recrutty/AutotuneGuitar/4_Full_Straight_Back_NA-6c7091648897df9198ad5ace94503ad4.jpg

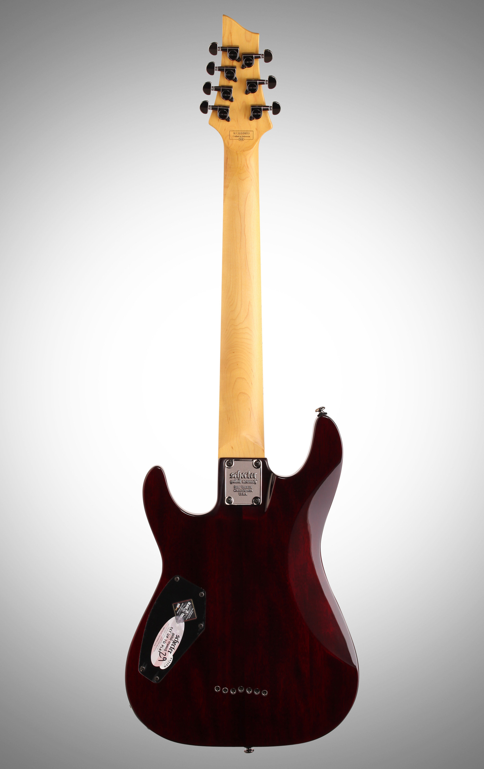
4_Full_Straight_Back_NA-6c7091648897df9198ad5ace94503ad4.jpg
