recrutty/AutotuneGuitar/sepisovani/semestrální projekt/DSC_0964.JPG

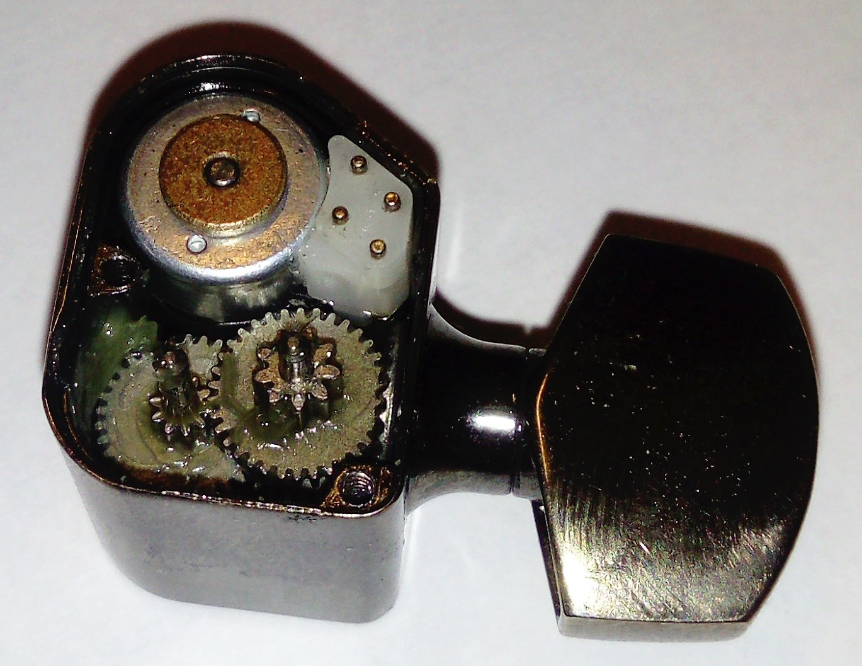
sepisovani/semestrální projekt/DSC_0964.JPG
