recrutty/AutotuneGuitar/sepisovani/Diplomka/prezentace/autotune obhajoba.pdf

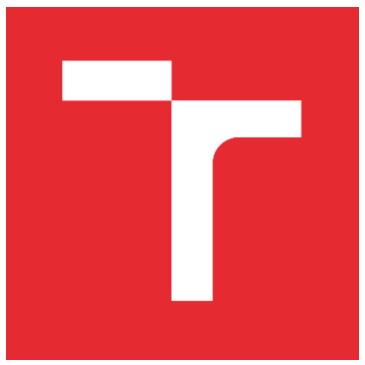
[picture p3: figure]

# SYSTÉM AUTOMATICKÉHO LADĚNÍ PRO SEDMISTRUNNÉ KYTARY

VYPRACOVAL: Bc. VOJTĚCH JEŘÁBEK VEDOUCÍ PRÁCE: Ing. VLADIMÍR LEVEK

# Obsah prezentace

### Systém TronicalTune

### Ladící mechanika RoboHead

### Analýza signálu kytary

### Realizace

### Ukázka funkce

# Systém TronicalTune

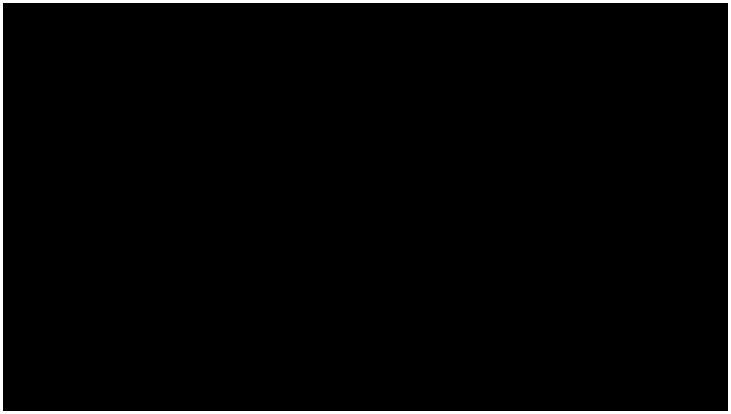
[picture p4: figure]

# Systém TronicalTune

Snímání vibrací
Žádný zásah
do konstrukce kytary

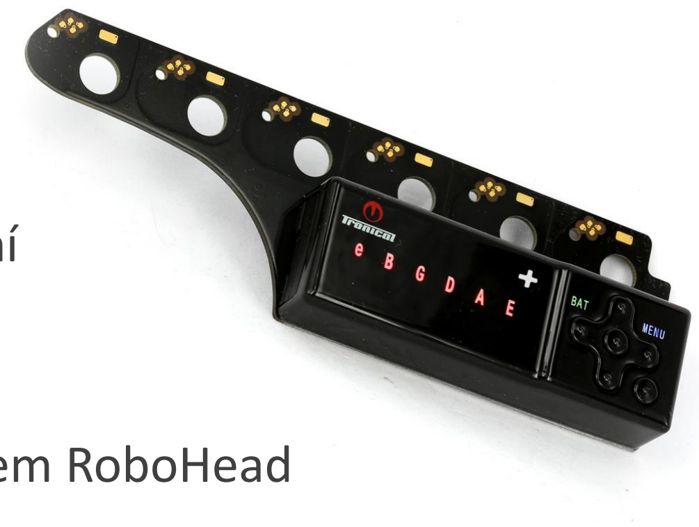
[picture p5: figure]

Možnost ručního ladění
bez použití elektroniky
Ladící mechanika
s integrovaným motorem RoboHead

# Ladící mechanika RoboHead

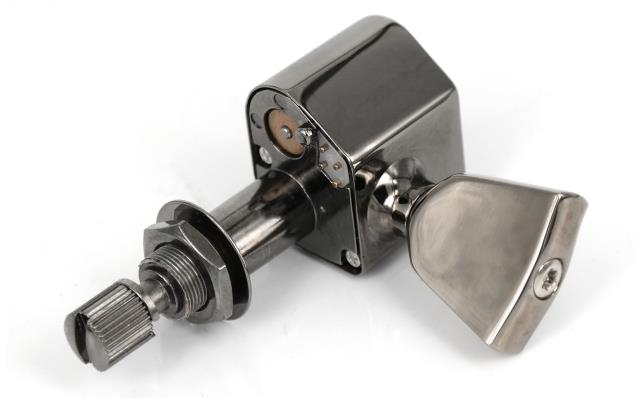
[picture p6: figure]

Dostupné jako náhradní díl pro
systém TronicalTune
Krokový motor
Odpor cívek 16 Ω
3800 kroků na otočení
9 V pro spolehlivé ladění
libovolné struny

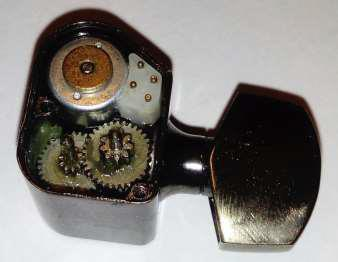
[picture p7: figure]

# Kmitočtová analýza

Struna H1, f = 61,74 Hz
Piezoelektrický senzor
Měření osciloskopem

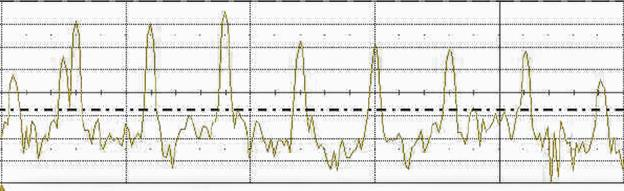
[picture p8: figure]

# Návrh zařízení

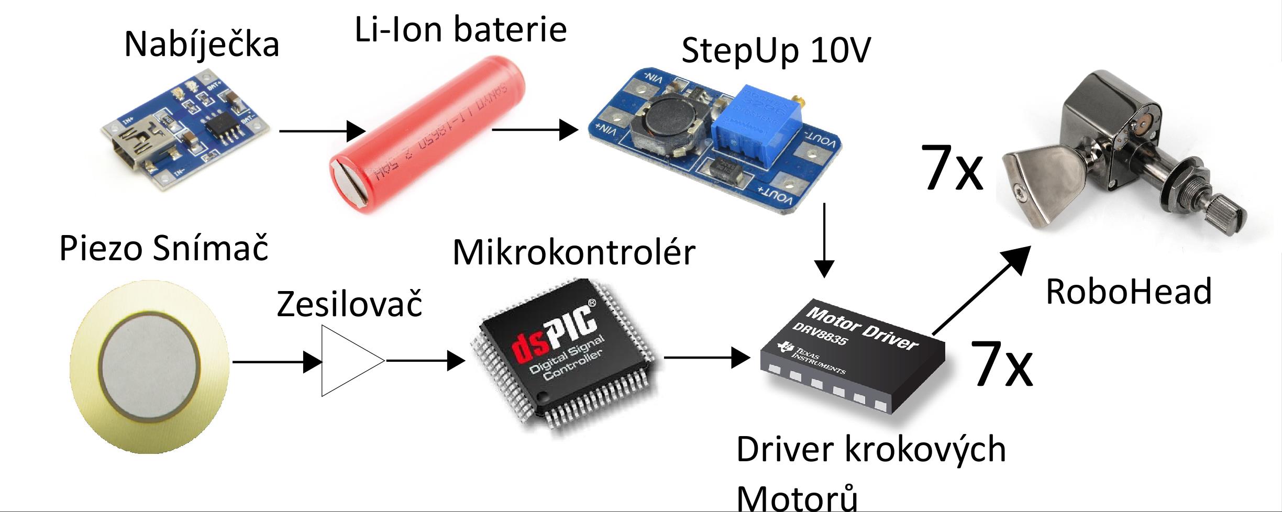
[picture p9: figure]

# Návrh zařízení

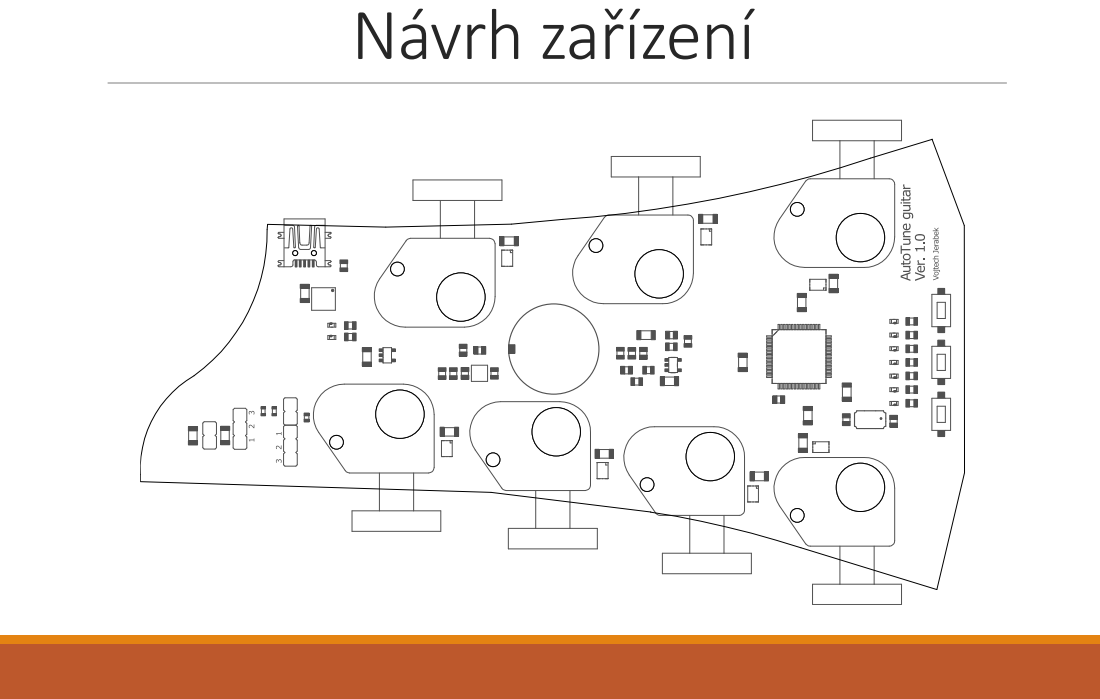
[picture p10: page 8]

# Výsledek

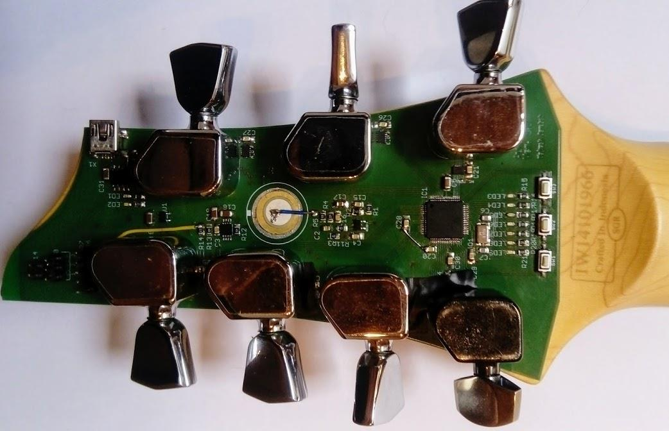
[picture p11: figure]

# Výsledek

### Systém je schopen samostatně pracovat bez dalších komponent

### Výběr a ladění libovolné struny samostatně

### Ochrana před ovlivnění šumem a nesprávným vyhodnocením

# Pokračování

### Integrace všech komponent na DPS

### Doplnění programu o funkci ladění všech strun zároveň, možnosti úpravy ladění

uživatelem a šetření baterie.

### Editace parametrů pomocí USB

# Děkuji za pozornost

PŘEJDEME K PRAKTICKÉ UKÁZCE
