recrutty/AutotuneGuitar/sepisovani/Diplomka/Data/btn.pdf

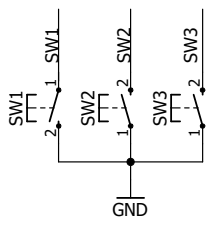
[picture p12: figure]
GND
