recrutty/AutotuneGuitar/sepisovani/Diplomka/Data/nabijecka bokem.pdf

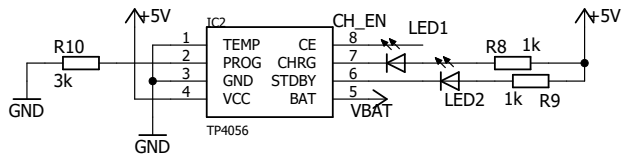
[picture p13: figure]
VBAT; GND; TEMP; PROG; VCC; 4 BAT; STDBY; CHRG; LED1; LED2
