recrutty/AutotuneGuitar/Sem proj obhajoba.pptx

## Systém automatického ladění pro sedmistrunné kytary

VYPRACOVAL: BC. VOJTĚCH JEŘÁBEK
VEDOUCÍ PRÁCE: Ing. Ladislav Macháň

## Obsah prezentace

- Shrnutí zadání a požadavků na práci
- Blokové schéma
- Popis senzorů zvuku a motorů
- Kmitočtová analýza signálu z kytary

## Zadání, požadavky

- Návrh elektrického i mechanického řešení
- Volba metody snímání zvuku
- Použití pro sedmistrunné kytary
- Ladění všech sedmi strun zároveň

## Blokové schéma

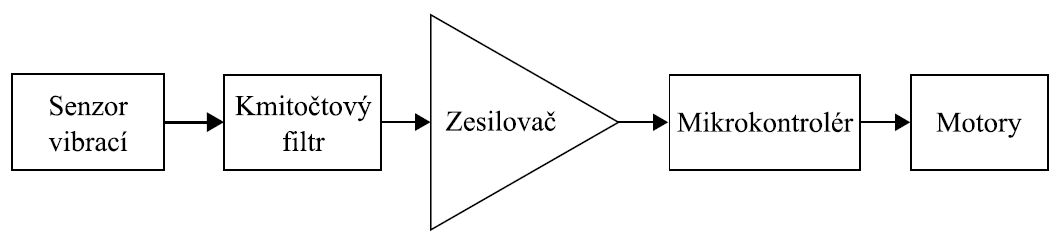
[picture p14: figure]

## Blokové schéma

Senzor vibrací:
- Elektrodynamický
- Piezoelektrický
- MEMS

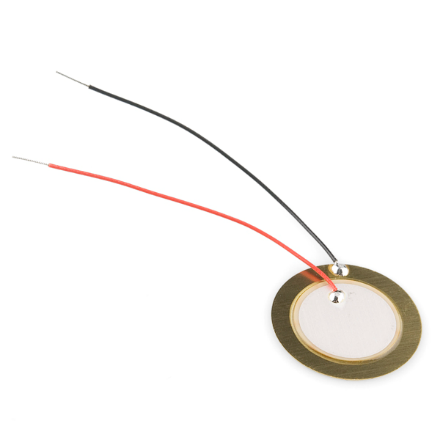
[picture p15: figure]

## Blokové schéma

Ladící mechanika RoboHead
- Krokový motor
- Odpor cívek 16 Ω
- 3800 kroků na otočení

## Kmitočtová analýza, FFT

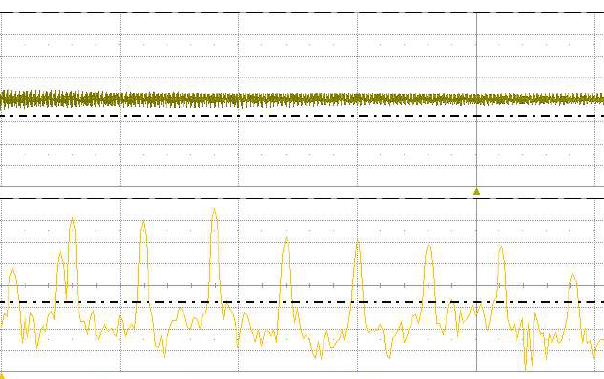
[picture p16: figure]
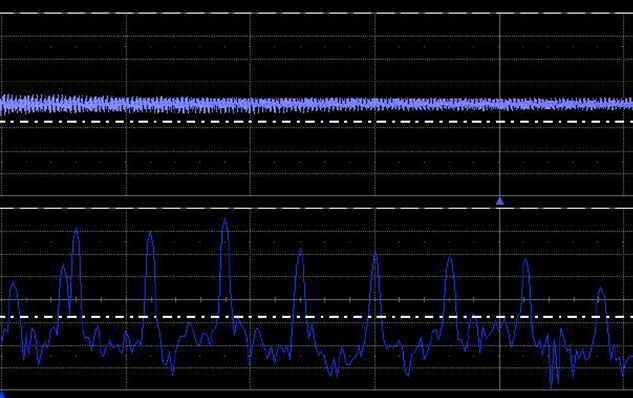
[picture p17: figure]

Struna H1
f = 61,74 Hz
Piezoelektrický
Senzor
Měření
osciloskopem

## Současný stav

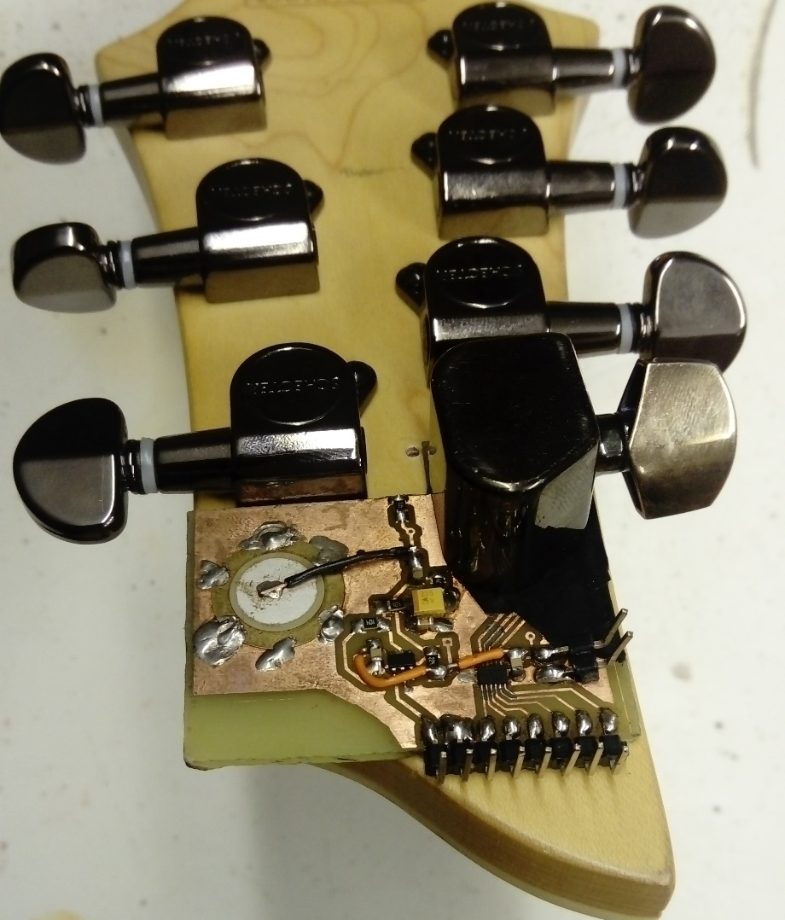
[picture p18: figure]

## Pokračování

- Výběr zbývajících komponent
- Dokončení kompletního schématu
- Konstrukce celého nařízení
- Program pro řízení

## Zdroje

- KUČERA, D. Koncepce tlačítkového piezo-generátoru. Brno: Vysoké učení technické v Brně, Fakulta strojního inženýrství, 2012. 46 s. Vedoucí bakalářské práce Ing. Zdeněk
- TronicalTune revolutionary guitar auto-tuning system unique the world. TronicalTune – selftuning Guitar in seconds! [online]. Hamburg, Germany: Tronical GmbH, 2014 [cit. 2016-11-13]. Dostupné z: http://www.tronical.com/

## Děkuji za pozornost

- Přejdeme k vašim dotazům
