recrutty/AutotuneGuitar/sepisovani/Diplomka/prezentace/EEICT.pdf

oihi

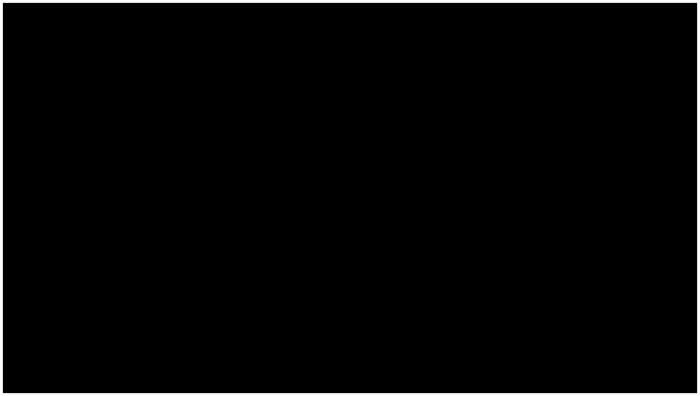
[picture p19: figure]

,jkuhuh
