recrutty/AutotuneGuitar/sepisovani/semestrální projekt/fft oscilo/HDO4024-MS Hardcopy 8.pdf

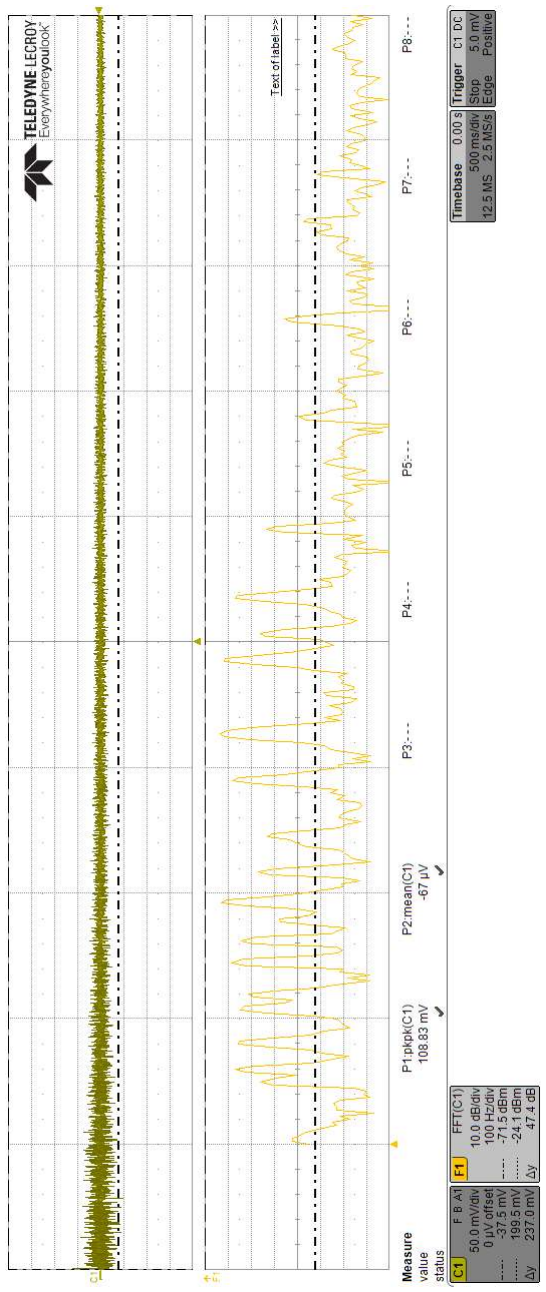
[picture p20: figure]
