recrutty/AutotuneGuitar/sepisovani/semestrální projekt/fft oscilo/HDO4024-MS Hardcopy.pdf

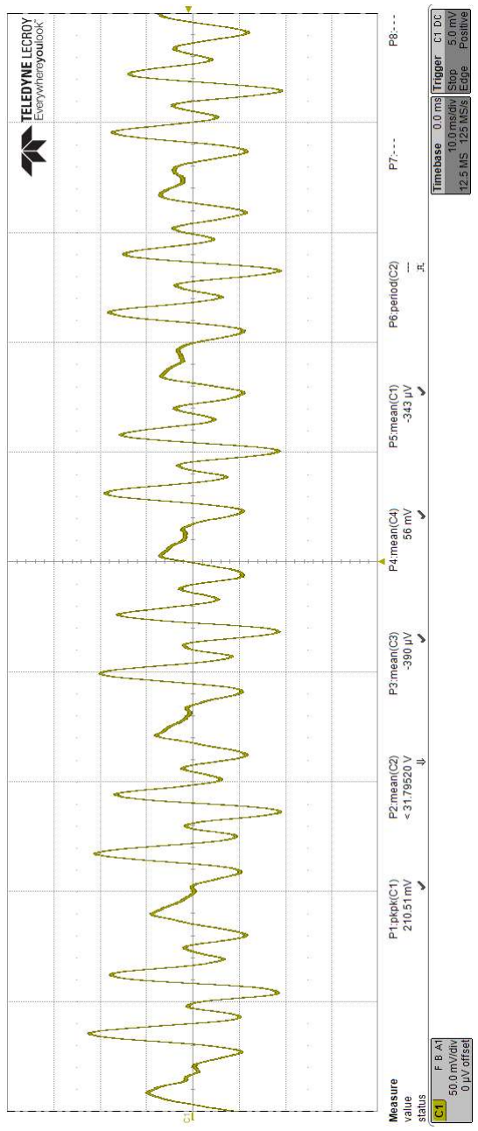
[picture p21: figure]
