recrutty/AutotuneGuitar/sepisovani/semestrální projekt/fft oscilo/HDO4024-MS Hardcopy2.pdf

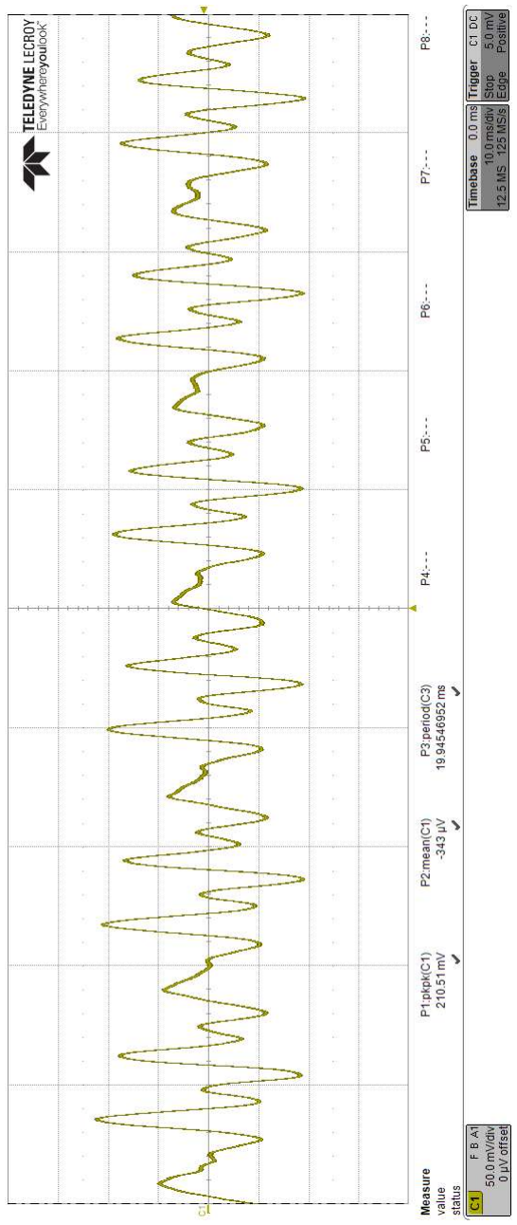
[picture p22: figure]
