recrutty/AutotuneGuitar/sepisovani/semestrální projekt/fft oscilo/HDO4024-MS Hardcopy3.pdf

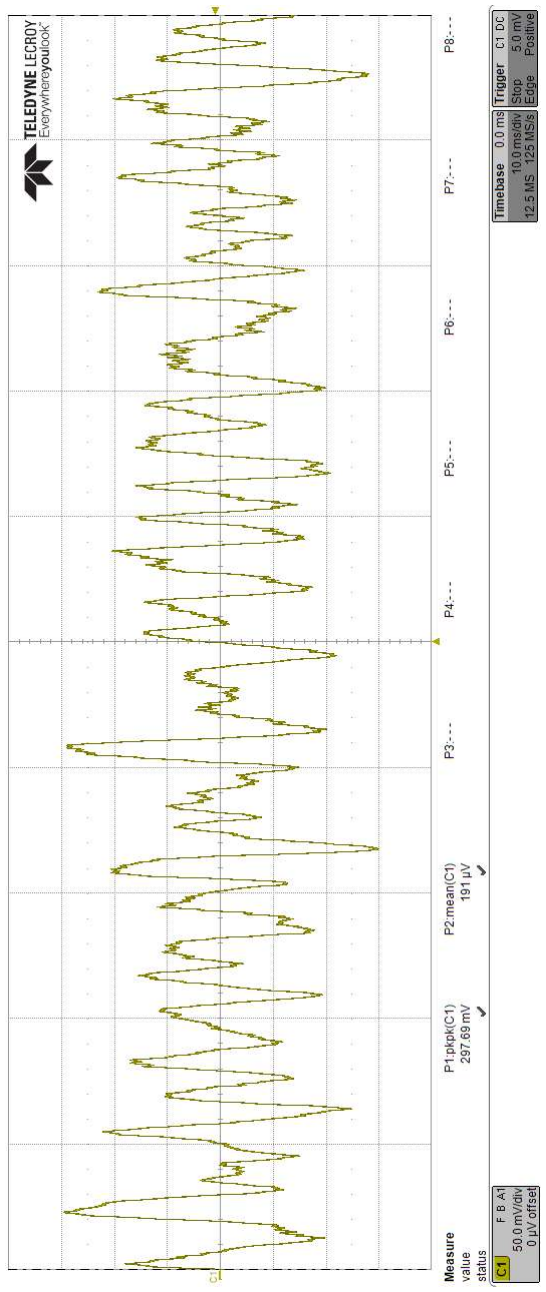
[picture p23: figure]
