recrutty/AutotuneGuitar/sepisovani/semestrální projekt/fft oscilo/HDO4024-MS Hardcopy4.pdf

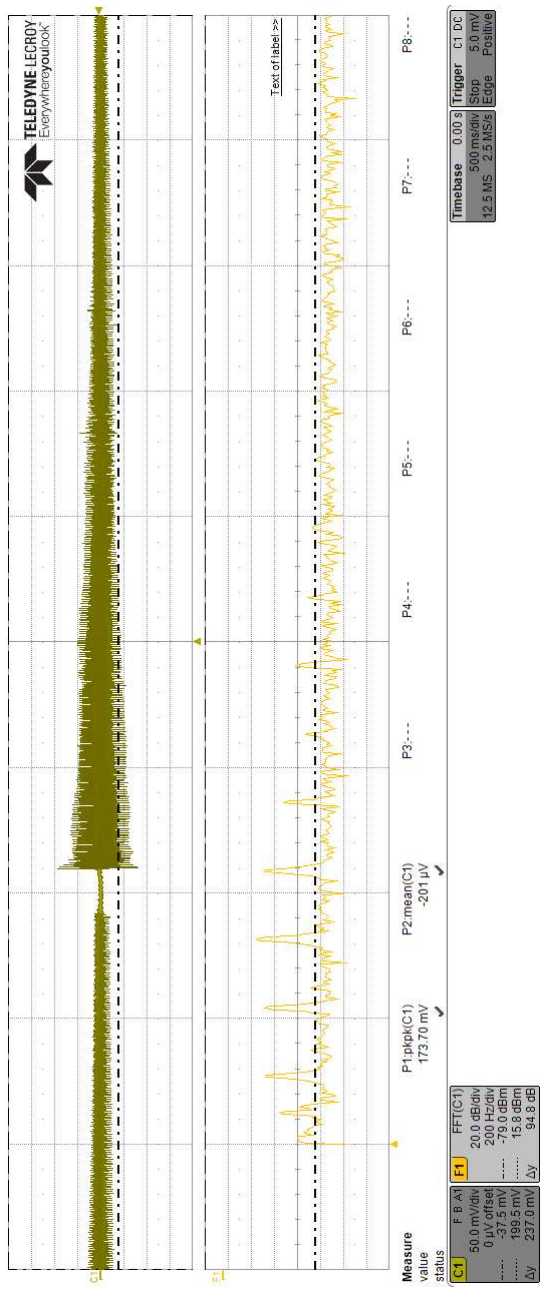
[picture p24: figure]
