recrutty/AutotuneGuitar/Icsp-pinouts.png

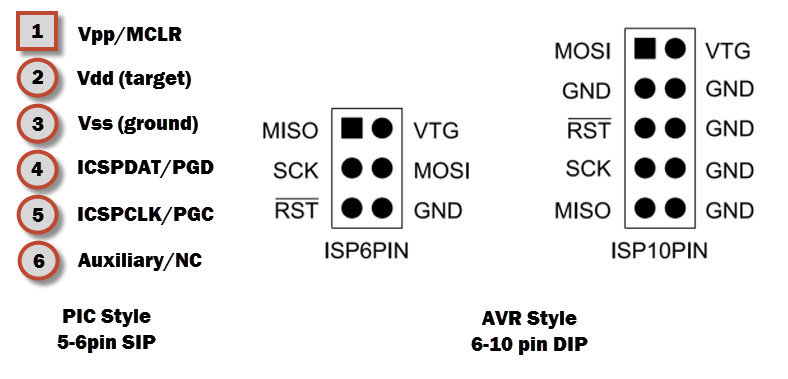
Icsp-pinouts.png
