recrutty/AutotuneGuitar/sepisovani/Diplomka/Data/DSC_0104 (1).JPG

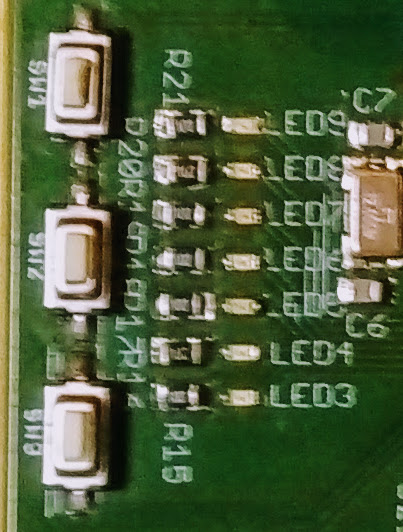
sepisovani/Diplomka/Data/DSC_0104 (1).JPG
