recrutty/AutotuneGuitar/sepisovani/Diplomka/prezentace/FFT.png

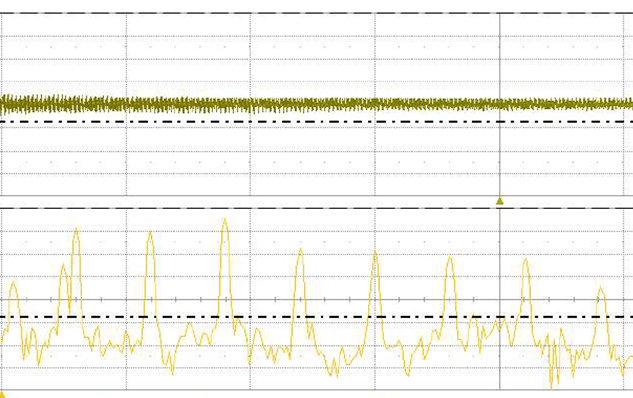
sepisovani/Diplomka/prezentace/FFT.png
