recrutty/AutotuneGuitar/sepisovani/semestrální projekt/DSC_0963.JPG

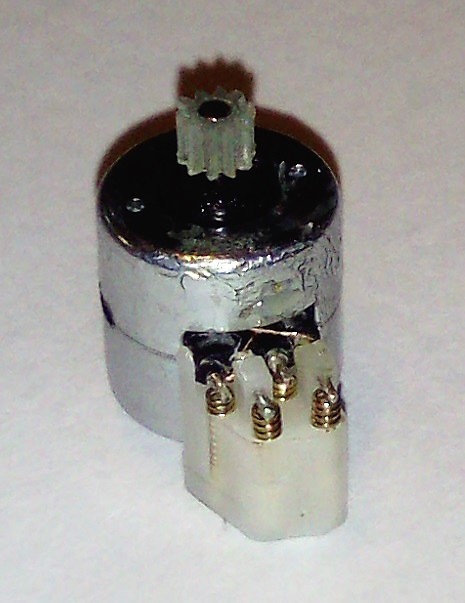
sepisovani/semestrální projekt/DSC_0963.JPG
