recrutty/AutotuneGuitar/sepisovani/semestrální projekt/fft oscilo/all2.png

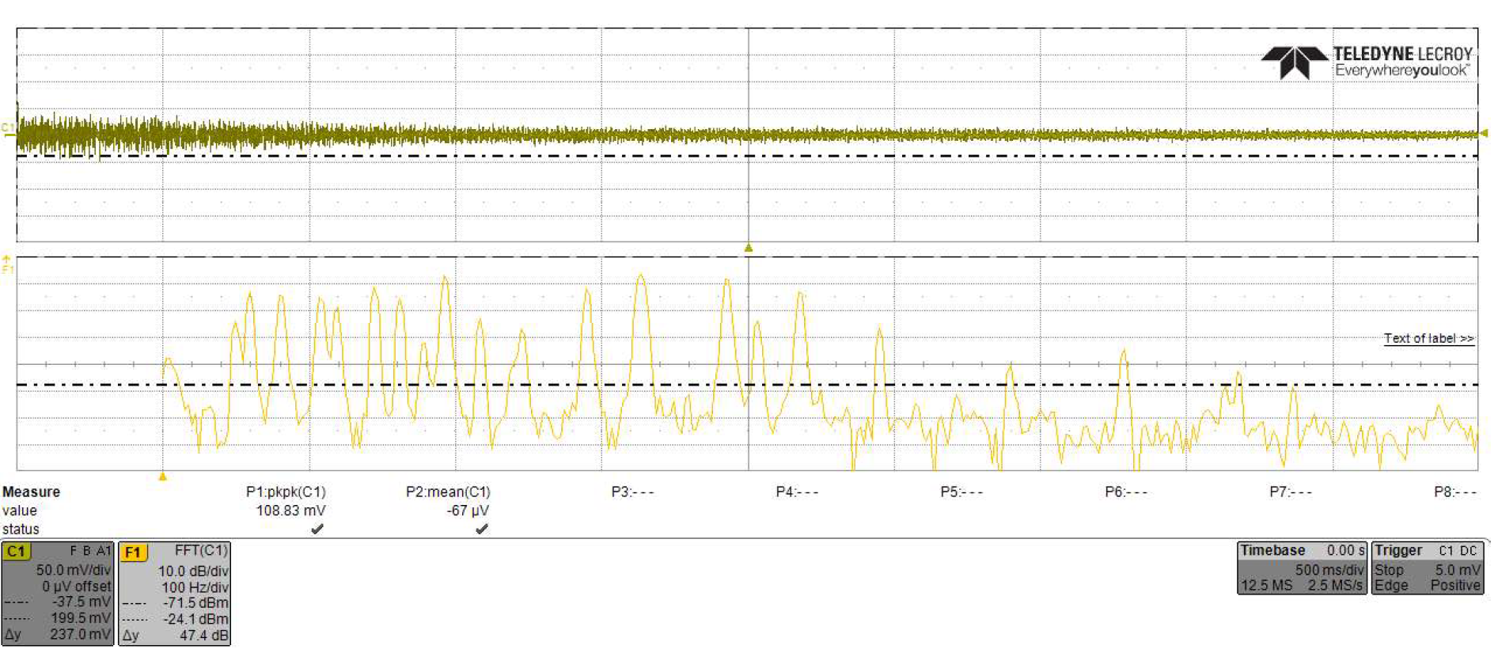
sepisovani/semestrální projekt/fft oscilo/all2.png
