recrutty/AutotuneGuitar/sepisovani/semestrální projekt/fft oscilo/all max.png

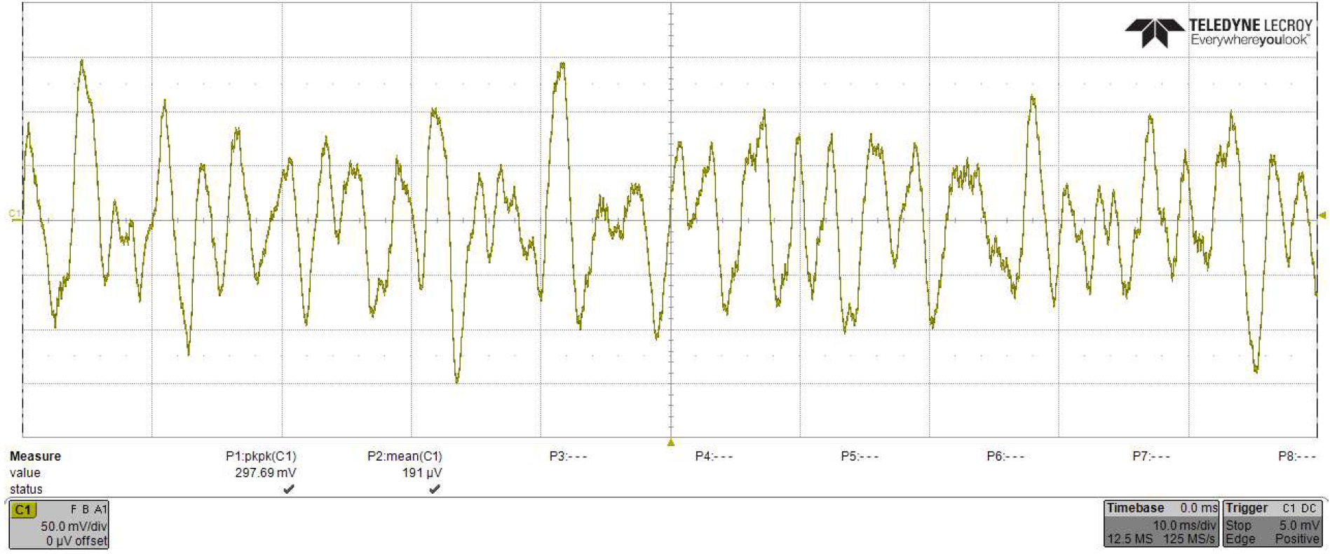
sepisovani/semestrální projekt/fft oscilo/all max.png
