recrutty/AutotuneGuitar/sepisovani/semestrální projekt/fft oscilo/all.png

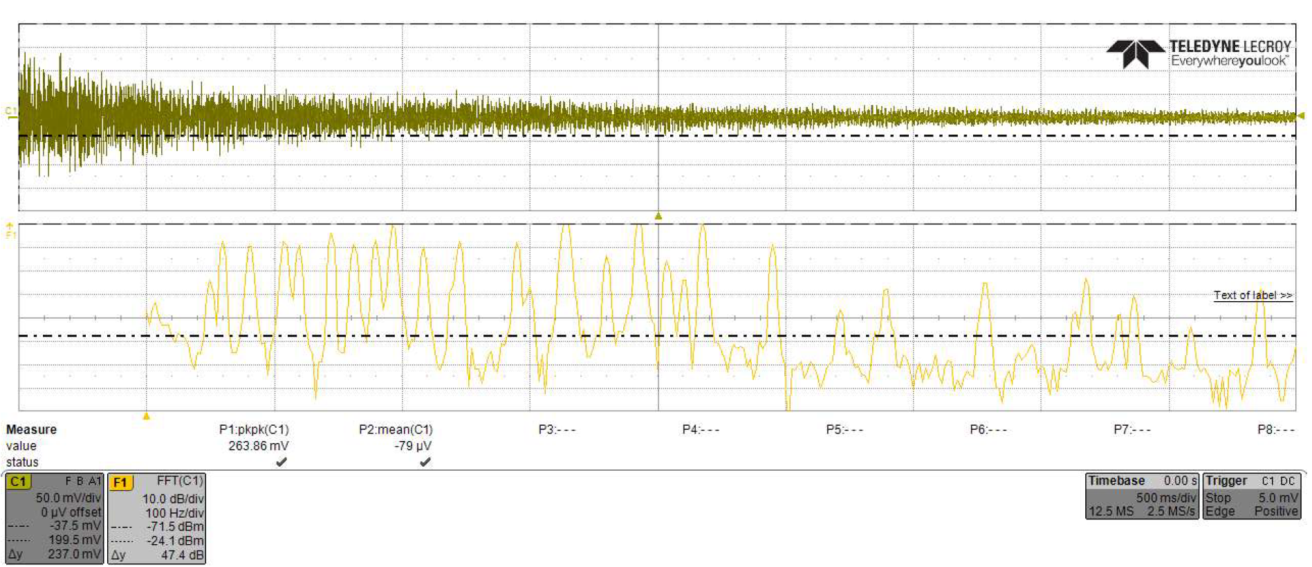
sepisovani/semestrální projekt/fft oscilo/all.png
