recrutty/AutotuneGuitar/sepisovani/semestrální projekt/fft oscilo/h fft.png

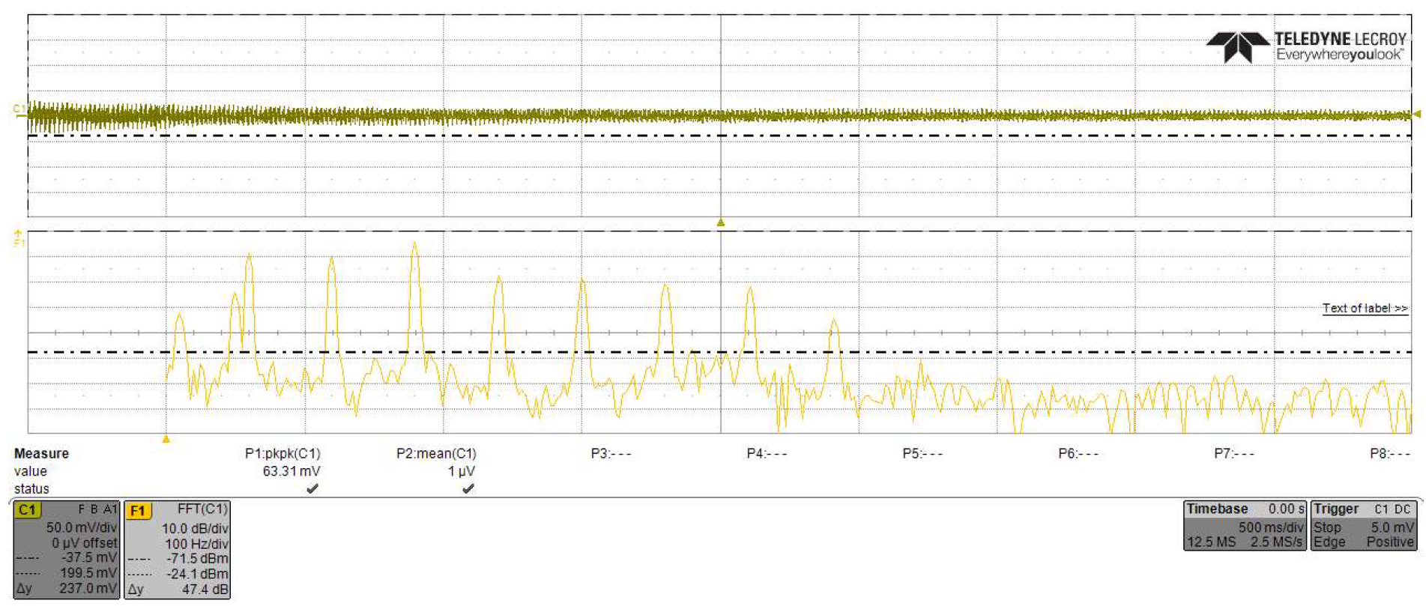
sepisovani/semestrální projekt/fft oscilo/h fft.png
