recrutty/AutotuneGuitar/sepisovani/semestrální projekt/fft oscilo/h max.png

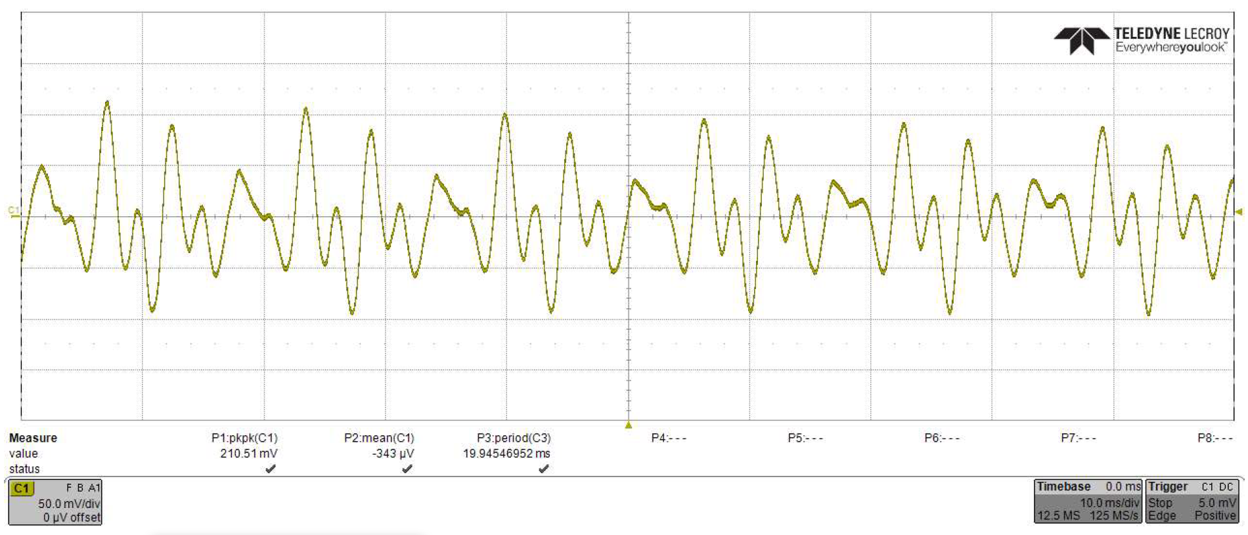
sepisovani/semestrální projekt/fft oscilo/h max.png
