recrutty/AutotuneGuitar/deska/final/Schecter7HS.dxf

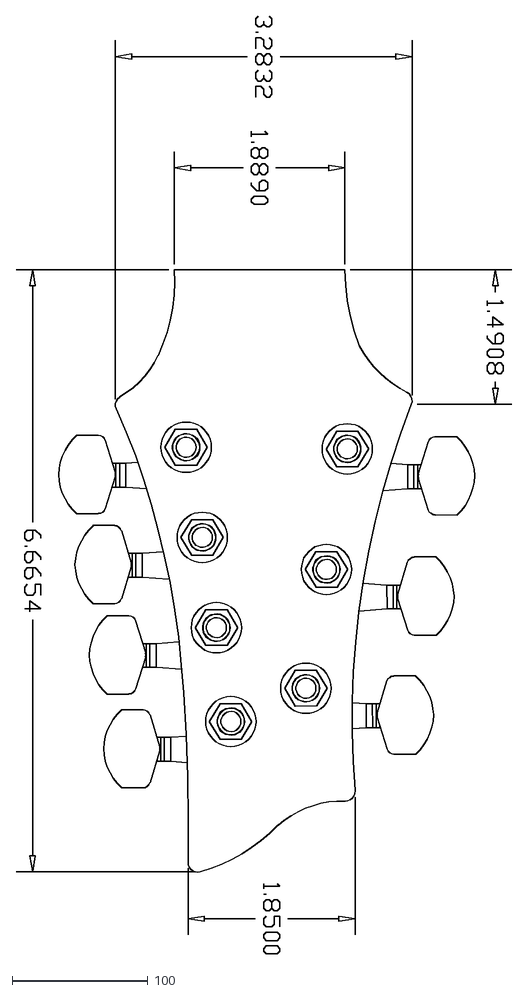
[picture p37: CAD file, 2017-02-22]
deska/final/Schecter7HS.dxf
364.5 x 690.7
