recrutty/AutotuneGuitar/sepisovani/Diplomka/Data/stepUp.pdf

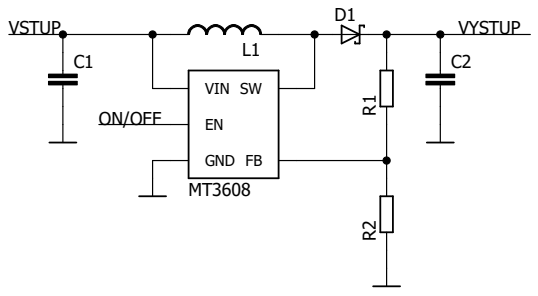
[picture p38: figure]
VIN; GND; VSTUP; VYSTUP; ON/OFF
