recrutty/AutotuneGuitar/SW/Auto_Tune_guitar_1/data.csv

OutputValues[0] | 5
OutputValues[1] | 0
OutputValues[2] | 0
OutputValues[3] | 0
OutputValues[4] | 0
OutputValues[5] | 0
OutputValues[6] | 0
OutputValues[7] | 0
OutputValues[8] | 0
OutputValues[9] | 0
OutputValues[10] | 0
OutputValues[11] | 0
OutputValues[12] | 0
OutputValues[13] | 0
OutputValues[14] | 0
OutputValues[15] | 0
OutputValues[16] | 0
OutputValues[17] | 0
OutputValues[18] | 0
OutputValues[19] | 0
OutputValues[20] | 0
OutputValues[21] | 0
OutputValues[22] | 0
OutputValues[23] | 0
OutputValues[24] | 0
OutputValues[25] | 0
OutputValues[26] | 0
OutputValues[27] | 0
OutputValues[28] | 0
OutputValues[29] | 0
OutputValues[30] | 0
OutputValues[31] | 0
OutputValues[32] | 0
OutputValues[33] | 0
OutputValues[34] | 0
OutputValues[35] | 0
OutputValues[36] | 0
OutputValues[37] | 0
OutputValues[38] | 0
OutputValues[39] | 0
OutputValues[40] | 0
OutputValues[41] | 0
OutputValues[42] | 0
OutputValues[43] | 0
OutputValues[44] | 0
OutputValues[45] | 0
OutputValues[46] | 0
OutputValues[47] | 0
OutputValues[48] | 0
OutputValues[49] | 0
OutputValues[50] | 0
OutputValues[51] | 0
OutputValues[52] | 0
OutputValues[53] | 0
OutputValues[54] | 0
OutputValues[55] | 0
OutputValues[56] | 0
OutputValues[57] | 0
OutputValues[58] | 0
OutputValues[59] | 0
OutputValues[60] | 0
OutputValues[61] | 0
OutputValues[62] | 0
OutputValues[63] | 0
OutputValues[64] | 0
OutputValues[65] | 0
OutputValues[66] | 0
OutputValues[67] | 0
OutputValues[68] | 0
OutputValues[69] | 0
OutputValues[70] | 0
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
OutputValues[1012] | 2
OutputValues[1013] | 1
OutputValues[1014] | 0
OutputValues[1015] | 0
OutputValues[1016] | 0
OutputValues[1017] | 0
OutputValues[1018] | 0
OutputValues[1019] | 0
OutputValues[1020] | 0
OutputValues[1021] | 0
OutputValues[1022] | 0
OutputValues[1023] | 0
