recrutty/AutotuneGuitar/ADC DATA/FFT/test.csv

output[0] | 0
output[1] | 0
output[2] | 1
output[3] | 0
output[4] | 1
output[5] | 0
output[6] | 1
output[7] | 0
output[8] | 1
output[9] | 0
output[10] | 1
output[11] | 0
output[12] | 1
output[13] | 0
output[14] | 1
output[15] | 0
output[16] | 1
output[17] | 0
output[18] | 1
output[19] | 0
output[20] | 1
output[21] | 0
output[22] | 1
output[23] | 0
output[24] | 1
output[25] | 0
output[26] | 1
output[27] | 0
output[28] | 1
output[29] | 0
output[30] | 1
output[31] | 0
output[32] | 1
output[33] | 0
output[34] | 2
output[35] | 0
output[36] | 2
output[37] | 0
output[38] | 2
output[39] | 0
output[40] | 3
output[41] | 0
output[42] | 5
output[43] | 1
output[44] | 7
output[45] | 1
output[46] | 13
output[47] | 2
output[48] | 33
output[49] | 7
output[50] | 224
output[51] | 830
output[52] | 483
output[53] | 10
output[54] | 38
output[55] | 2
output[56] | 12
output[57] | 1
output[58] | 6
output[59] | 1
output[60] | 3
output[61] | 0
output[62] | 2
output[63] | 0
output[64] | 1
output[65] | 0
output[66] | 1
output[67] | 0
output[68] | 1
output[69] | 0
output[70] | 1
output[71] | 0
output[72] | 0
output[73] | 0
output[74] | 0
output[75] | 0
output[76] | 0
output[77] | 0
output[78] | 0
output[79] | 0
output[80] | 0
output[81] | 0
output[82] | 0
output[83] | 0
output[84] | 0
output[85] | 0
output[86] | 0
output[87] | 0
output[88] | 0
output[89] | 0
output[90] | 0
output[91] | 0
output[92] | 0
output[93] | 0
output[94] | 0
output[95] | 0
output[96] | 0
output[97] | 0
output[98] | 0
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
output[238] | 0
output[239] | 0
output[240] | 0
output[241] | 0
output[242] | 0
output[243] | 0
output[244] | 0
output[245] | 0
output[246] | 0
output[247] | 0
output[248] | 0
output[249] | 1
output[250] | 0
output[251] | 1
output[252] | 0
output[253] | 4
output[254] | 0
output[255] | 33
