recrutty/AutotuneGuitar/sepisovani/semestrální projekt/h mustky.pdf

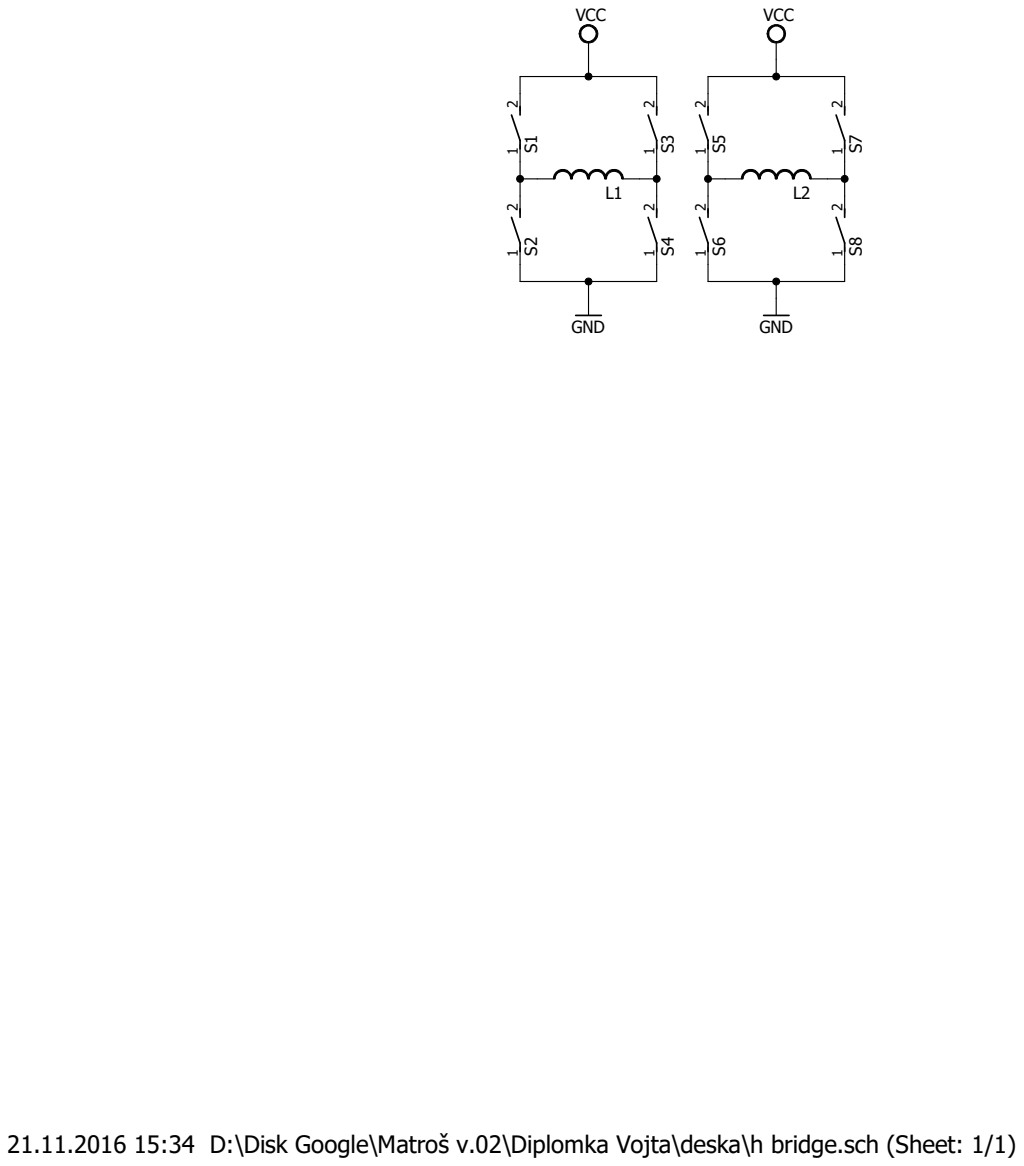
[picture p39: page 1]
VCC; GND

21.11.2016 15:34 D:\Disk Google\Matroš v.02\Diplomka Vojta\deska\h bridge.sch (Sheet: 1/1)
