recrutty/AutotuneGuitar/sepisovani/Diplomka/prezentace/board.pdf

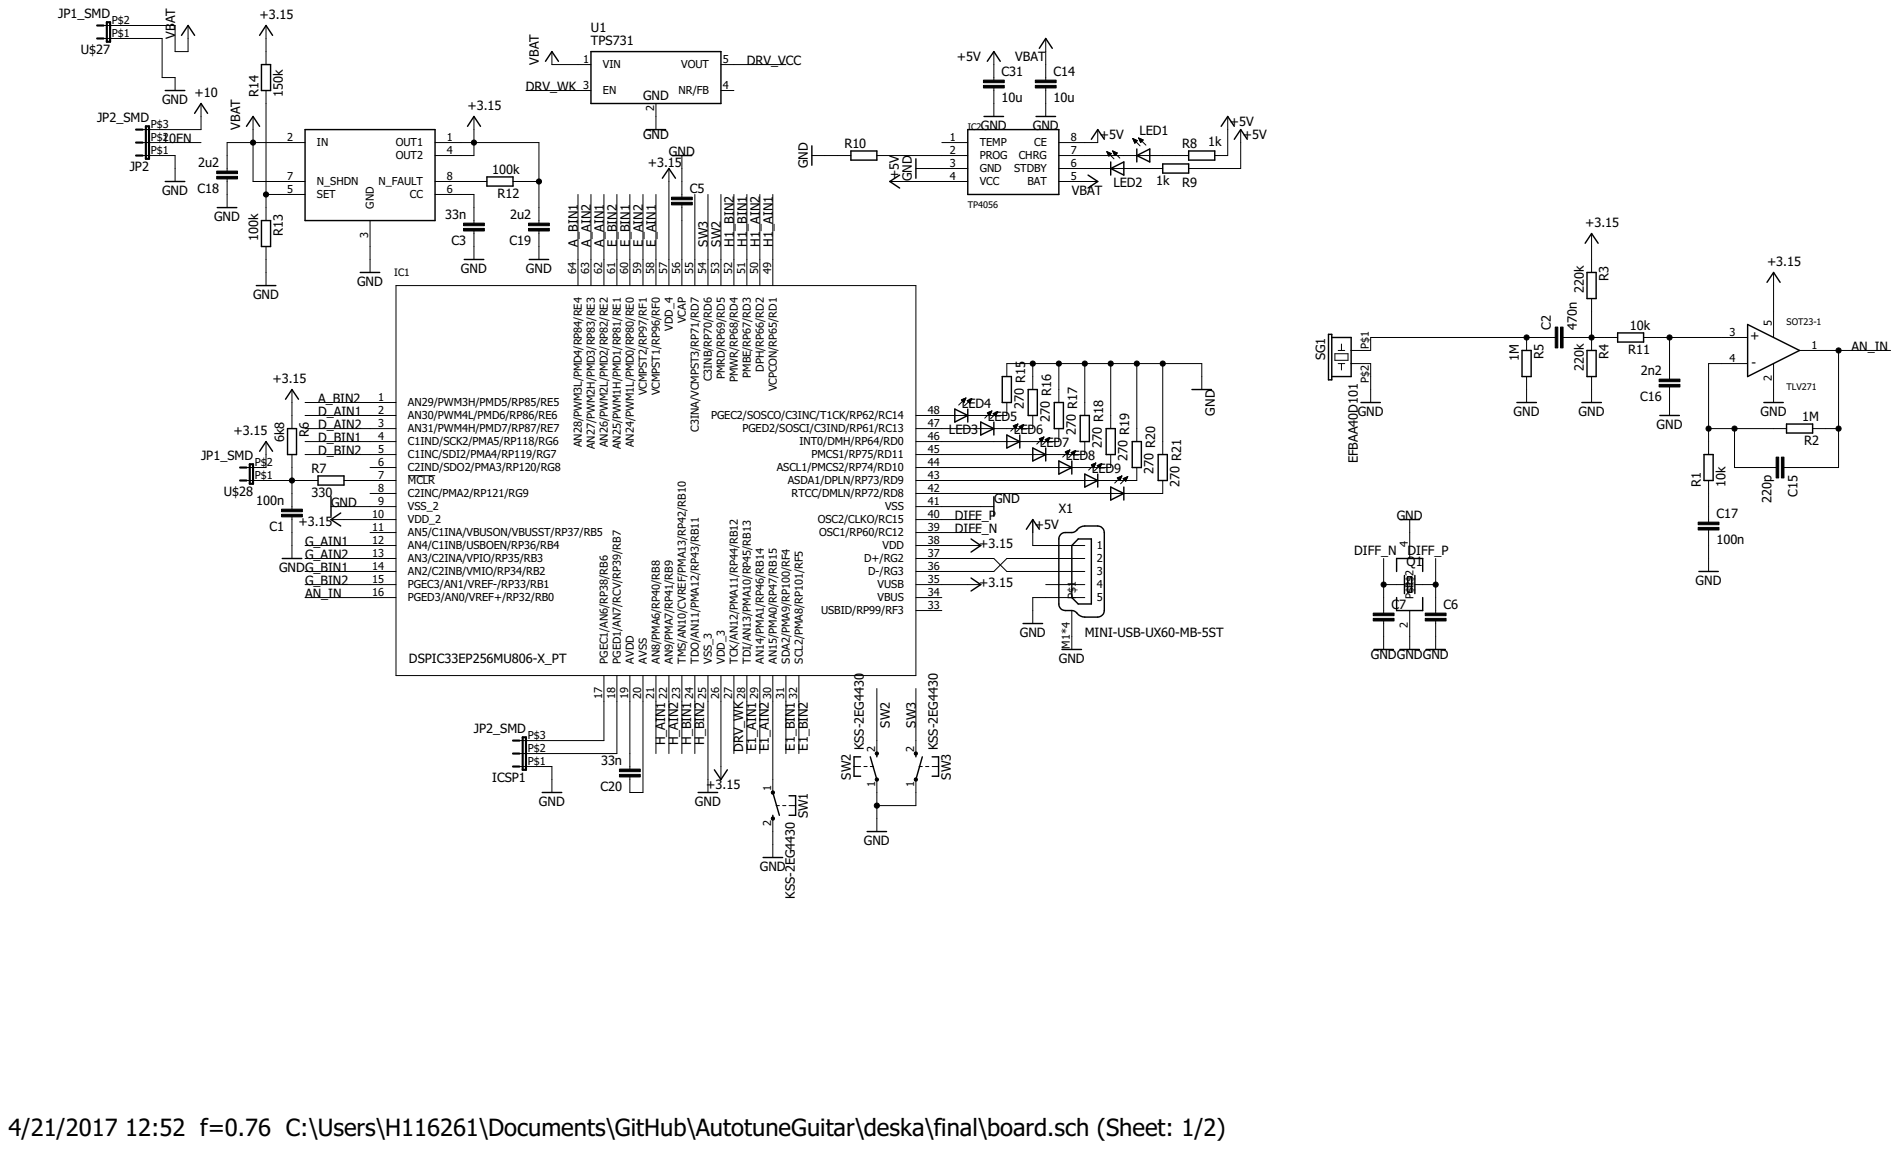
[picture p40: page 1]

4/21/2017 12:52 f=0.76 C:\Users\H116261\Documents\GitHub\AutotuneGuitar\deska\final\board.sch (Sheet: 1/2)
