recrutty/AutotuneGuitar/sepisovani/Na CD/Návrh DPS/Schéma/Část 3, Zdroje a zesilovač.pdf

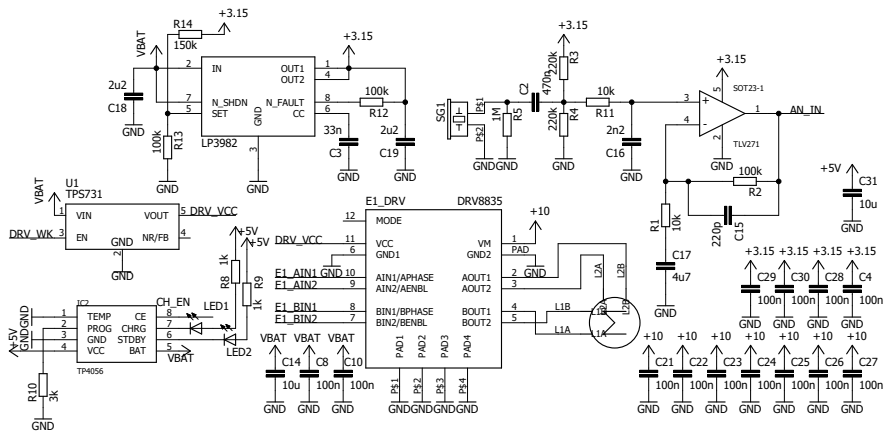
[picture p41: page 1]

GND GND GND
