recrutty/AutotuneGuitar/sepisovani/Na CD/Návrh DPS/Schéma/Část 1, krokové motory a řadiče.pdf

# L2B L2B L1A L1A L1B L1B

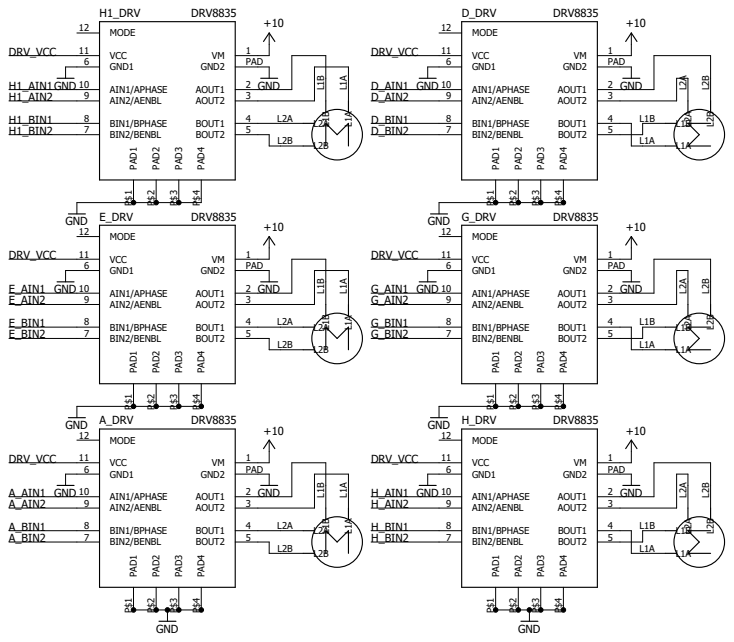
[picture p42: page 1]
GND; DRV8835; 1 VCC 11; AIN1/APHASE 10 AIN2/AENBL 9; BIN1/BPHASE 8 BIN2/BENBL 7; MODE 12; GND1 6; AOUT1; AOUT2; BOUT1; BOUT2; H1_DRVPAD¹ P$1; PAD² P$2; PAD³ P$3; PAD⁴ P$4; GND2; PAD; E_DRV PAD¹ P$1; A_DRV PAD¹ P$1; H_DRV PAD¹ P$1; G_DRV PAD¹ P$1; D_DRV PAD¹ P$1; PAD D_AIN1; D_AIN2; D_BIN1; H1_BIN2; D_BIN2; H1_BIN1; H1_AIN2; H1_AIN1; G_AIN1; A_AIN1 A_AIN2; A_BIN1 A_BIN2; E_AIN1 E_AIN2; E_BIN1 E_BIN2; H_AIN1 H_AIN2; H_BIN1 H_BIN2; DRV_VCC; G_AIN2; G_BIN1 G_BIN2
