recrutty/AutotuneGuitar/sepisovani/Na CD/Návrh DPS/Schéma/Část 2, Mikrokontrolér.pdf

100n

# GND

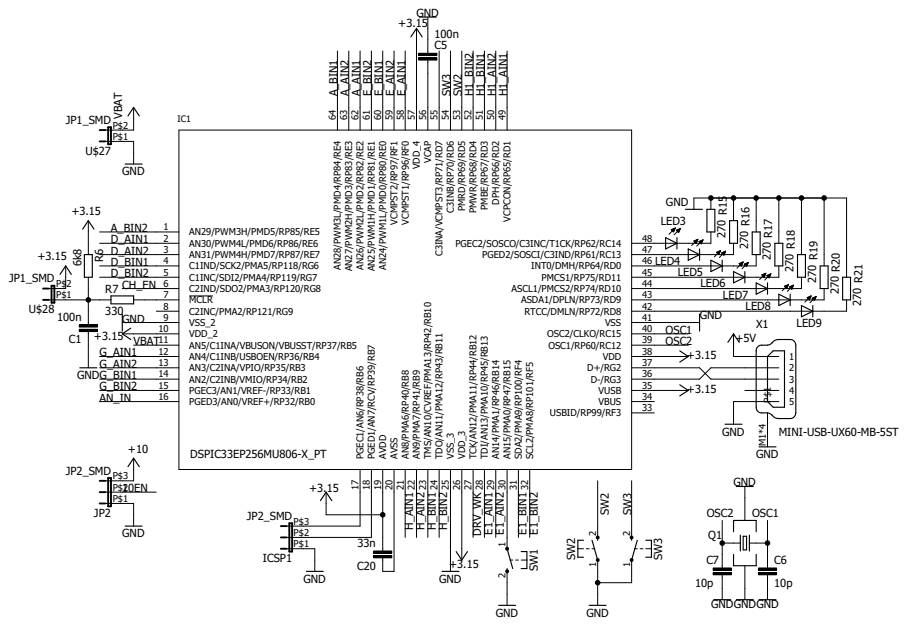
[picture p43: page 1]
