recrutty/AutotuneGuitar/sepisovani/Diplomka/Data/StepMotor.pdf

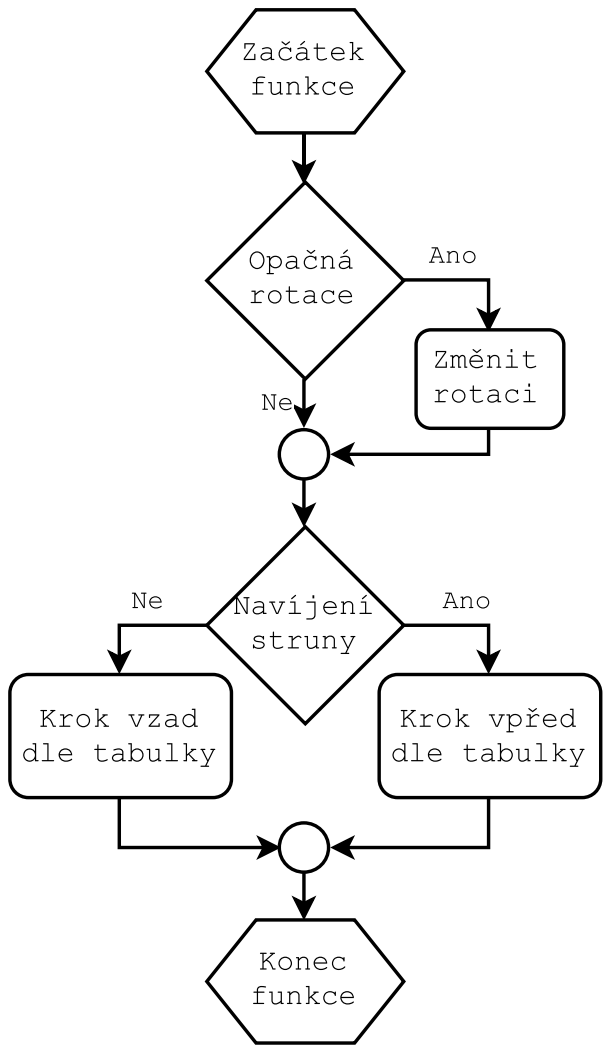
[picture p44: page 1]
