recrutty/AutotuneGuitar/deska/final/Schecter7HS.pdf

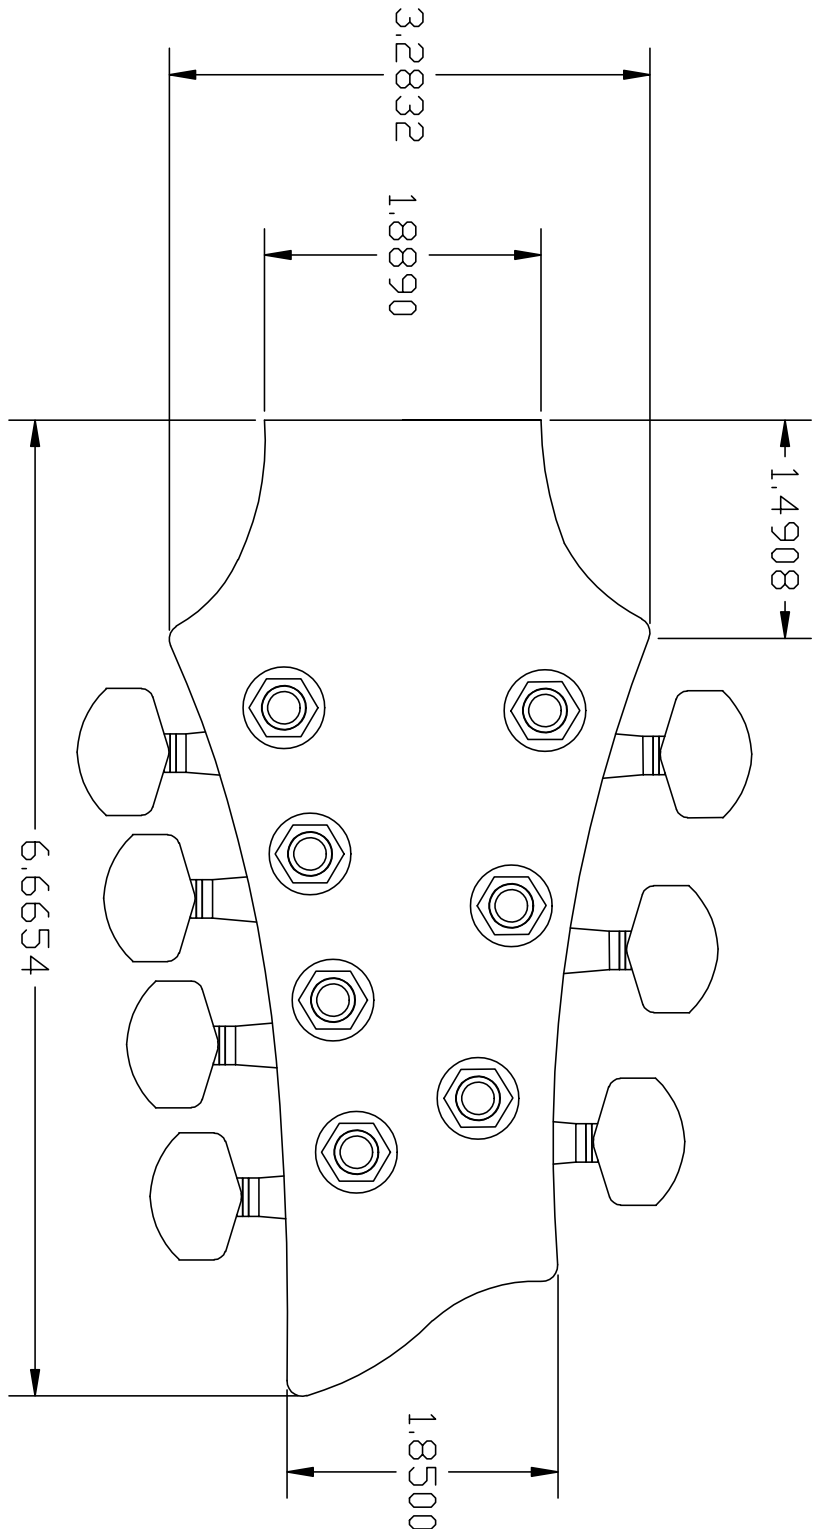
[picture p45: page 1]
