recrutty/AutotuneGuitar/deska/PDF/bot.pdf

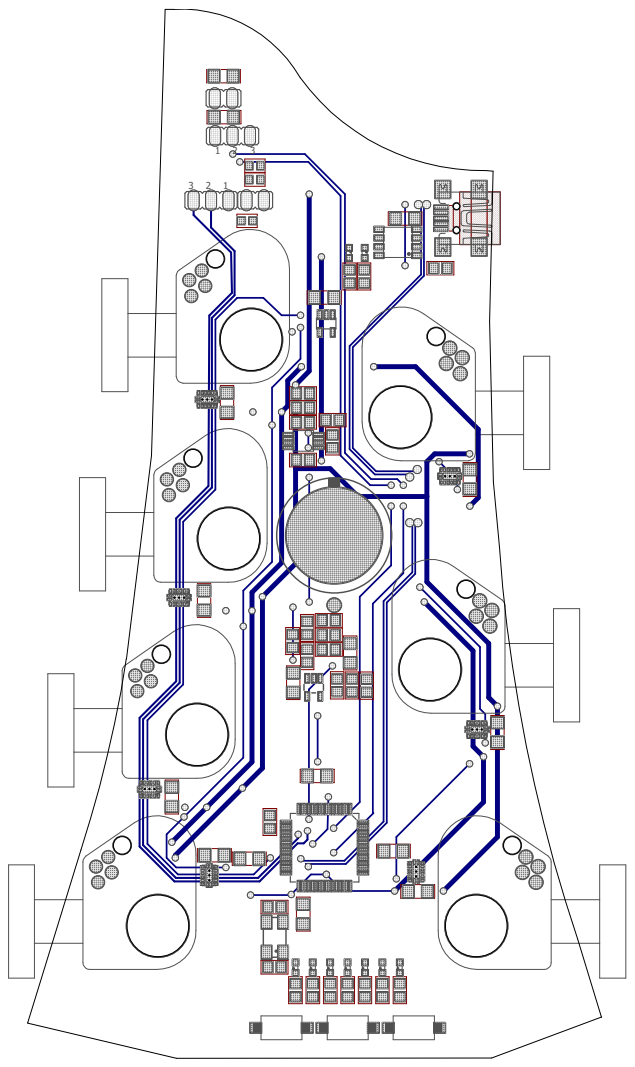
[picture p46: page 1]
