recrutty/AutotuneGuitar/deska/PDF/both.pdf

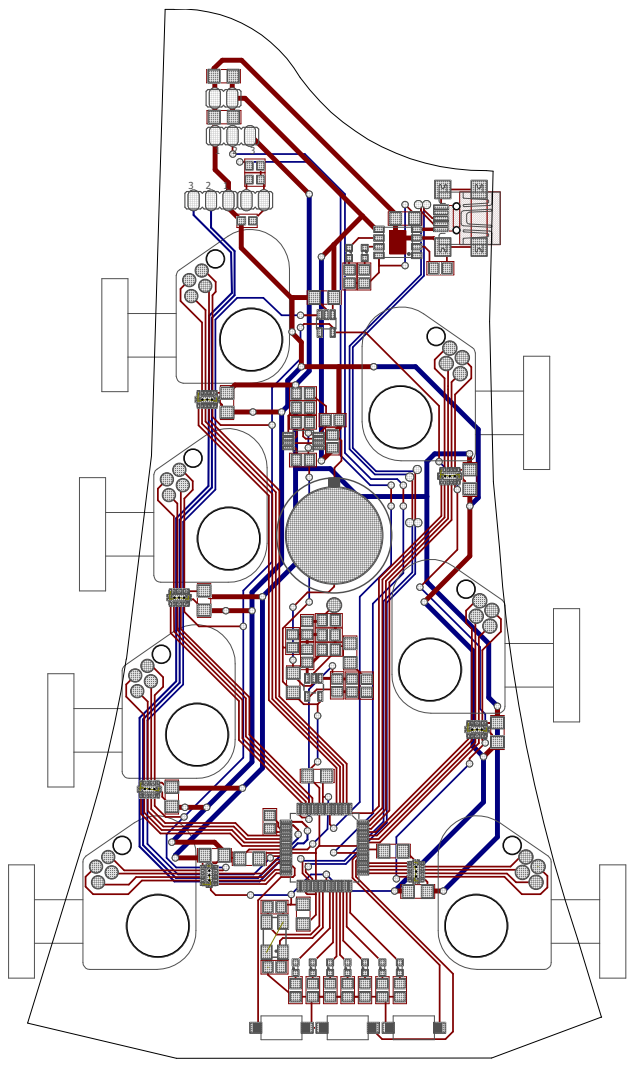
[picture p47: page 1]
