recrutty/AutotuneGuitar/deska/PDF/top.pdf

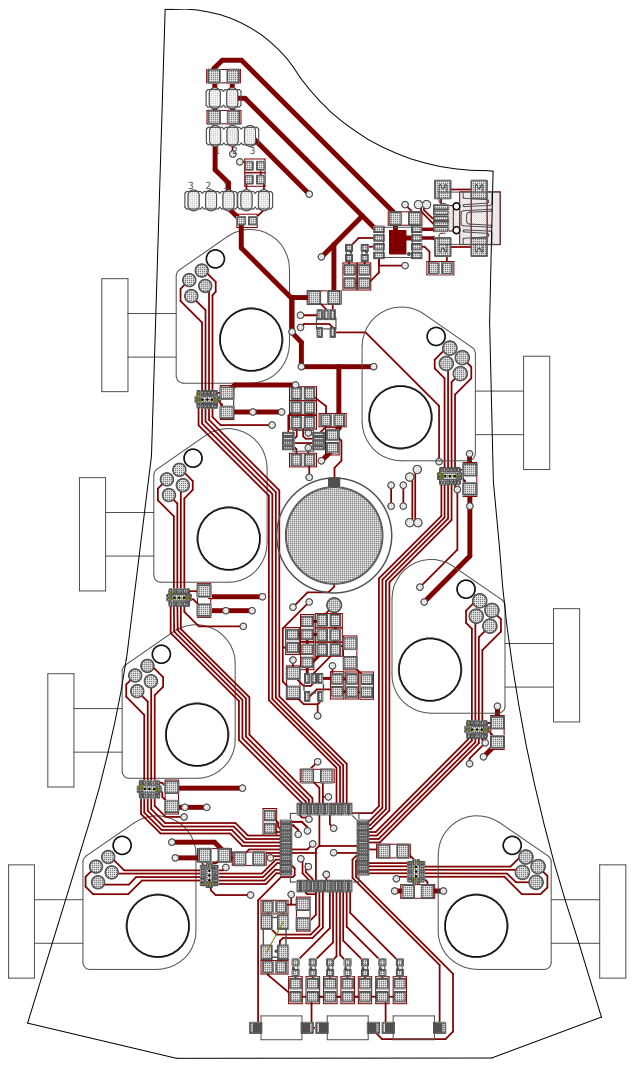
[picture p48: page 1]
