recrutty/AutotuneGuitar/sepisovani/Diplomka/Data/analyza.pdf

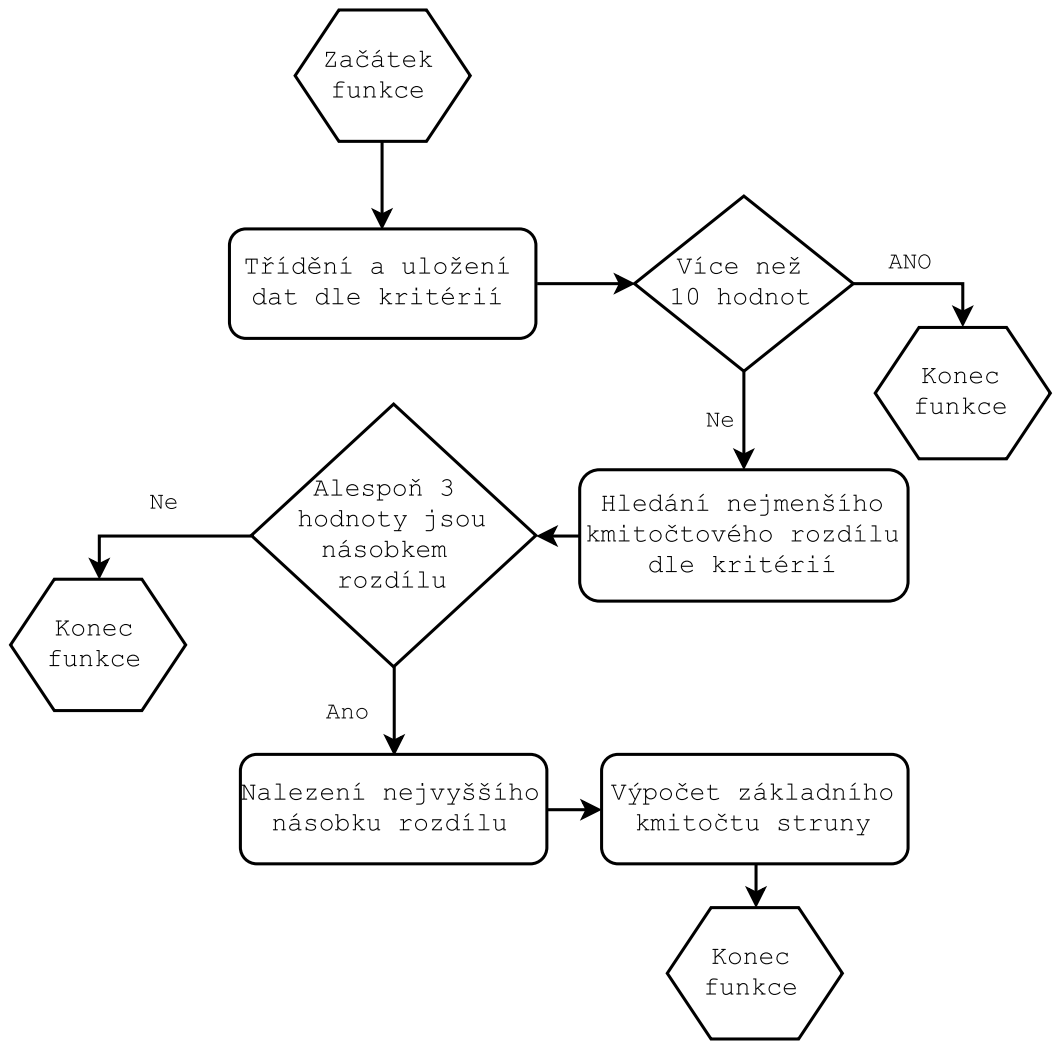
[picture p49: page 1]
