recrutty/AutotuneGuitar/sepisovani/Diplomka/Data/leds.pdf

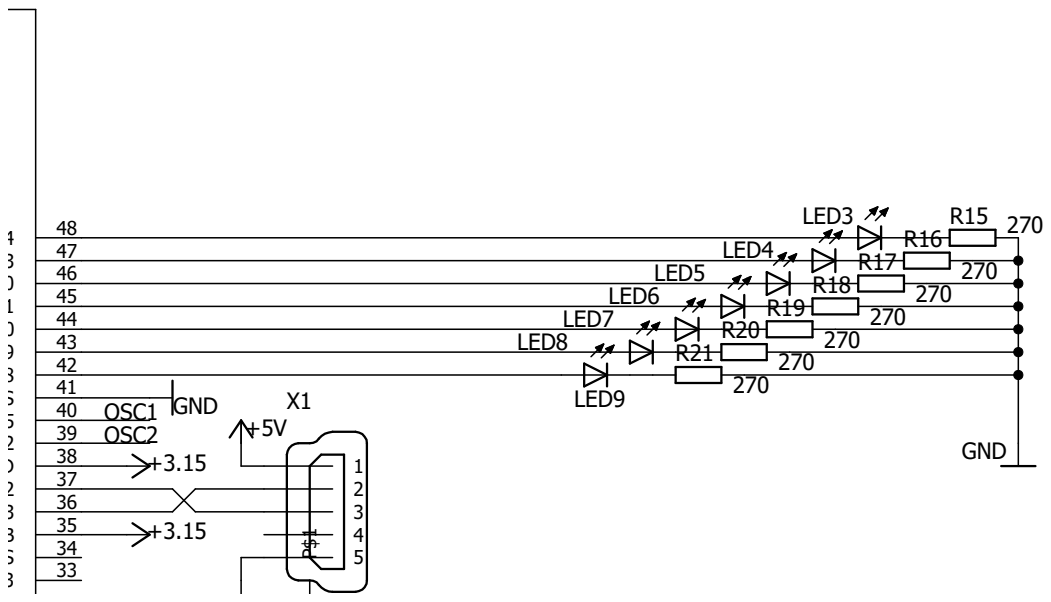
[picture p50: page 1]
