recrutty/AutotuneGuitar/sepisovani/Diplomka/Data/zesil zapojeni.pdf

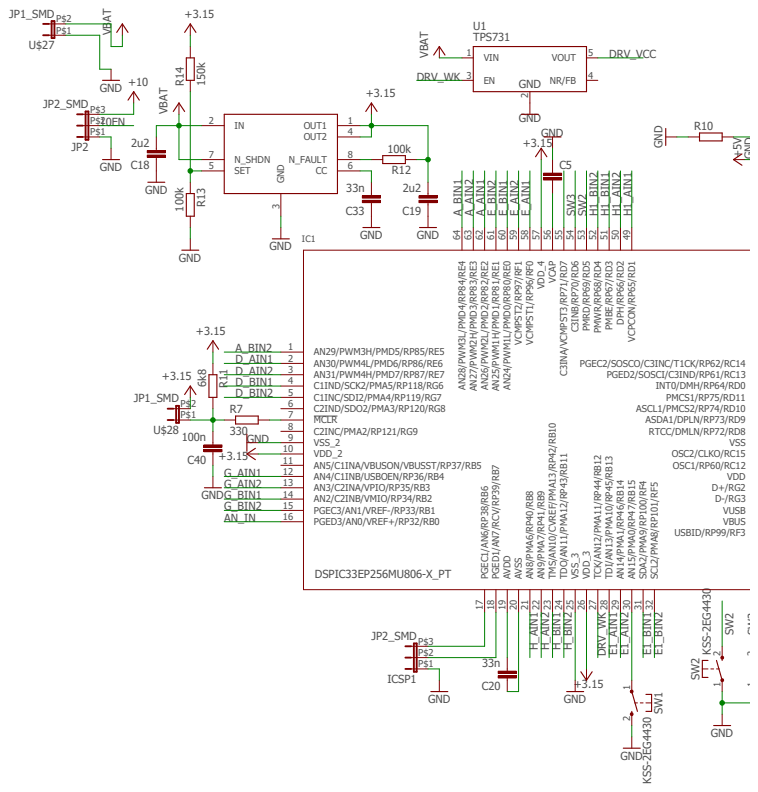
[picture p51: page 1]

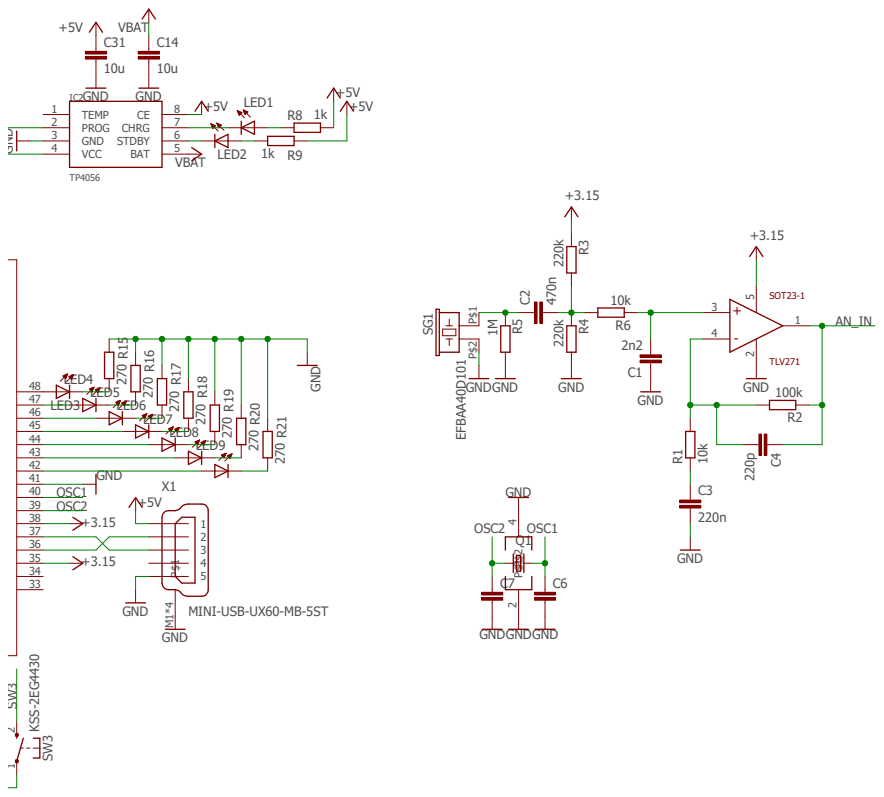
[picture p52: page 2]
