recrutty/AutotuneGuitar/sepisovani/Na CD/Návrh DPS/Plošný spoj/Horní strana.pdf

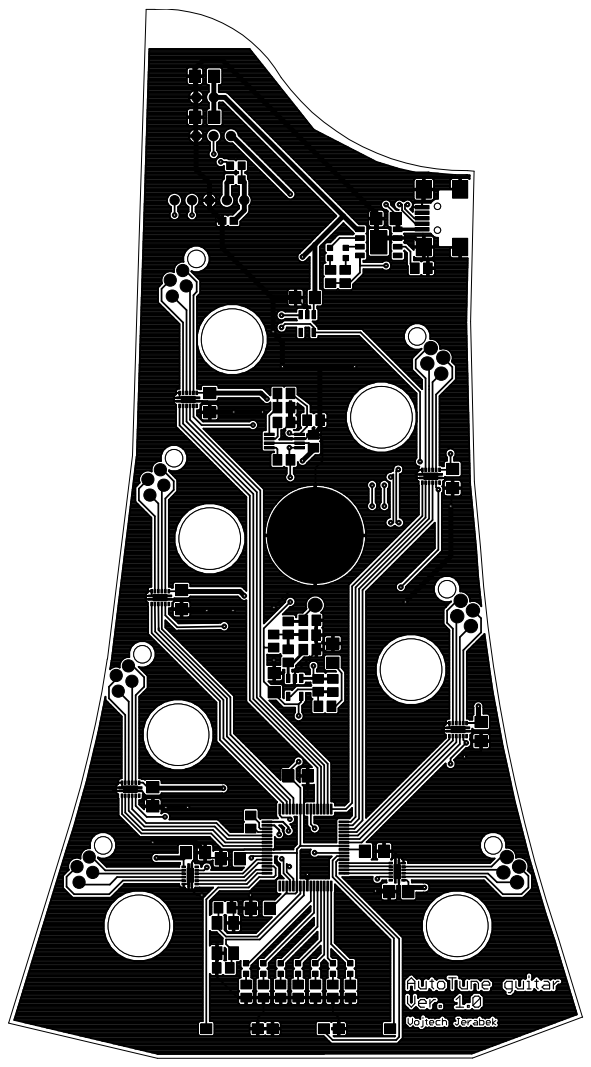
[picture p53: page 1]
