recrutty/AutotuneGuitar/sepisovani/Na CD/Návrh DPS/Plošný spoj/Rozmístění součástek.pdf

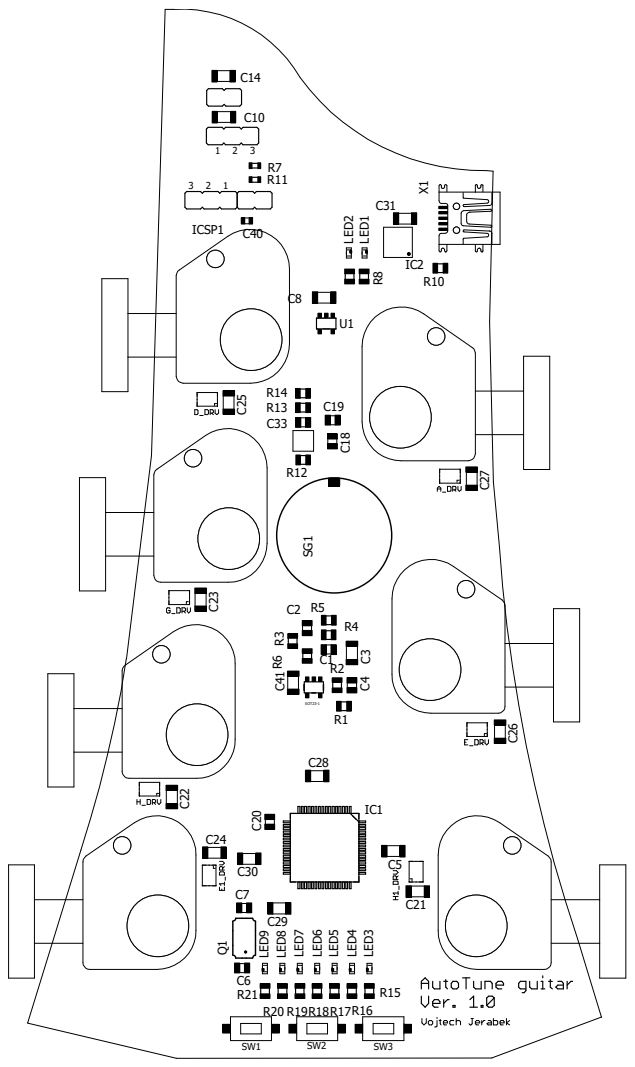
[picture p54: page 1]
