recrutty/AutotuneGuitar/sepisovani/Na CD/Návrh DPS/Plošný spoj/Spodní strana.pdf

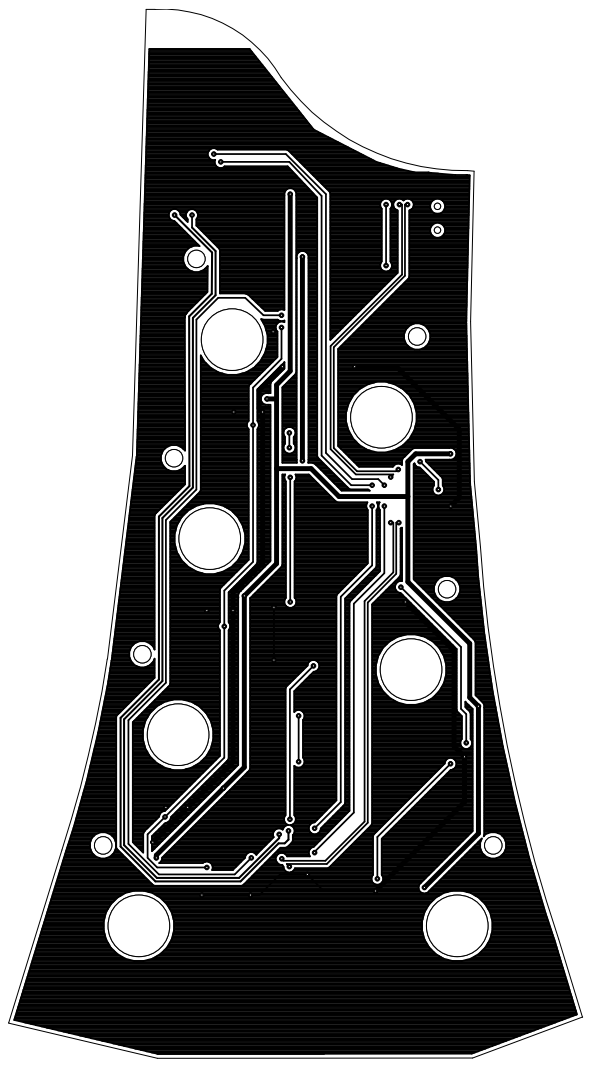
[picture p55: page 1]
