recrutty/AutotuneGuitar/deska/final/board.brd

## EAGLE design deska/final/board.brd (2017-04-23)

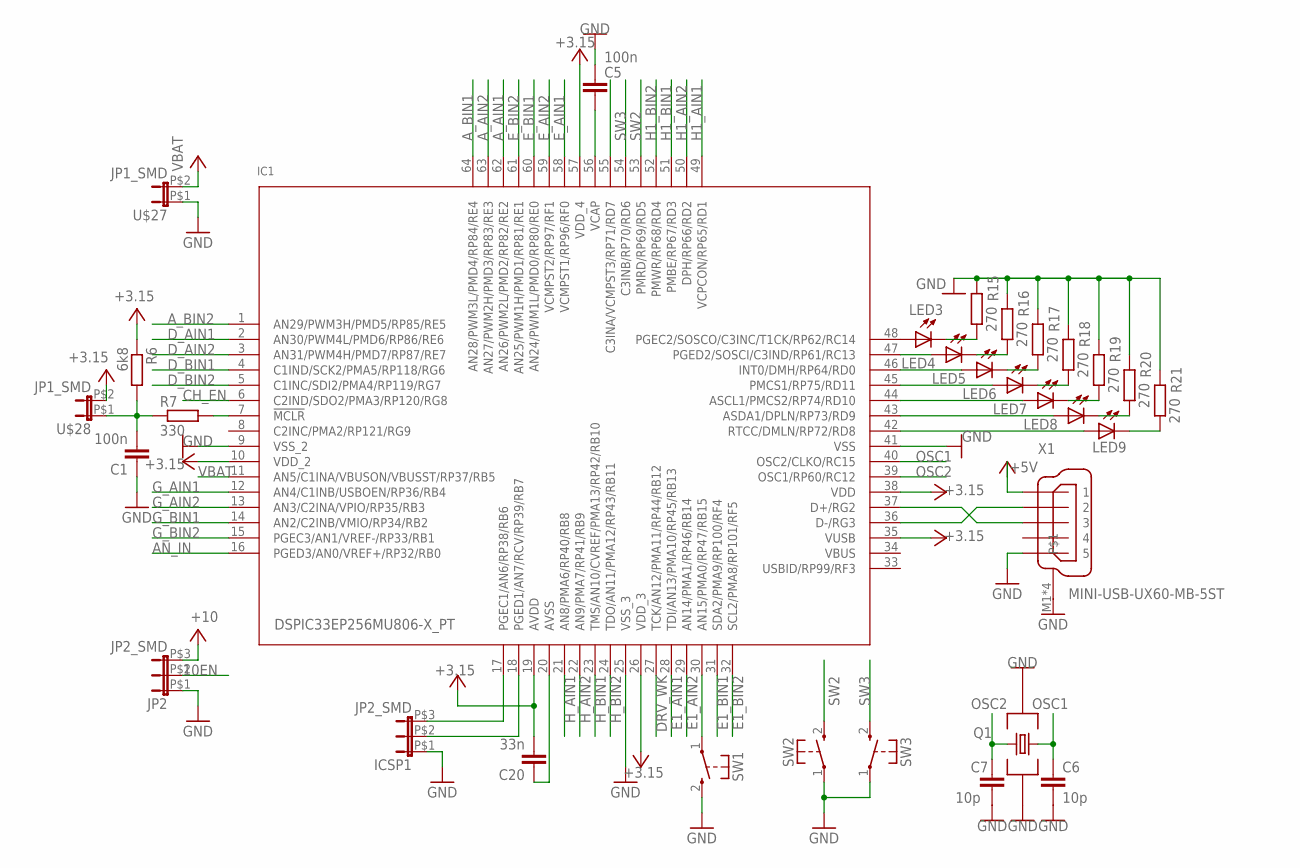
[picture p56: schematic board.sch, sheet 1]

Parts:
C1: 100n; C0603
C5: 100n; C1206
C6, C7: 10p; C0805
C20: 33n; C0805
IC1: DSPIC33EP256MU806-X_PT; QFP64-10X10MC
ICSP1: JP2_SMD
JP2: JP2_SMD
LED3, LED4, LED5, LED6, LED7, LED8, LED9: LED_ESML0603; LED_SML0603
Q1: CRYSTALCTS406; CTS406
R6: 6k8; R0603
R7: 330; R0603
R15, R16, R17, R18, R19, R20, R21: 270; R0805
SW1, SW2, SW3: KSS-2EG4430
U$27, U$28: JP1_SMD
X1: MINI-USB-UX60-MB-5ST; UX60-MB-5ST

Connections:
10EN: IC1.55 (C3INA/VCMPST3/RP71/RD7), JP2.P$2 (2)
+5V: X1.1; also elsewhere on the board
+10V: JP2.P$3 (3); also elsewhere on the board
AN_IN: IC1.16 (PGED3/AN0/VREF+/RP32/RB0); also elsewhere on the board
A_AIN1: IC1.62 (AN26/PWM2L/PMD2/RP82/RE2); also elsewhere on the board
A_AIN2: IC1.63 (AN27/PWM2H/PMD3/RP83/RE3); also elsewhere on the board
A_BIN1: IC1.64 (AN28/PWM3L/PMD4/RP84/RE4); also elsewhere on the board
A_BIN2: IC1.1 (AN29/PWM3H/PMD5/RP85/RE5); also elsewhere on the board
CH_EN: IC1.6 (C2IND/SDO2/PMA3/RP120/RG8); also elsewhere on the board
DIFF_N: C7.1, IC1.39 (OSC1/RP60/RC12), Q1.3 (2)
DIFF_NS: IC1.36 (D-/RG3), X1.2
DIFF_P: C6.1, IC1.40 (OSC2/CLKO/RC15), Q1.1
DIFF_PD: IC1.37 (D+/RG2), X1.3
DRV_WK: IC1.27 (TCK/AN12/PMA11/RP44/RB12); also elsewhere on the board
D_AIN1: IC1.2 (AN30/PWM4L/PMD6/RP86/RE6); also elsewhere on the board
D_AIN2: IC1.3 (AN31/PWM4H/PMD7/RP87/RE7); also elsewhere on the board
D_BIN1: IC1.4 (C1IND/SCK2/PMA5/RP118/RG6); also elsewhere on the board
D_BIN2: IC1.5 (C1INC/SDI2/PMA4/RP119/RG7); also elsewhere on the board
E1_AIN1: IC1.28 (TDI/AN13/PMA10/RP45/RB13); also elsewhere on the board
E1_AIN2: IC1.29 (AN14/PMA1/RP46/RB14); also elsewhere on the board
E1_BIN1: IC1.31 (SDA2/PMA9/RP100/RF4); also elsewhere on the board
E1_BIN2: IC1.32 (SCL2/PMA8/RP101/RF5); also elsewhere on the board
E_AIN1: IC1.58 (VCMPST1/RP96/RF0); also elsewhere on the board
E_AIN2: IC1.59 (VCMPST2/RP97/RF1); also elsewhere on the board
E_BIN1: IC1.60 (AN24/PWM1L/PMD0/RP80/RE0); also elsewhere on the board
E_BIN2: IC1.61 (AN25/PWM1H/PMD1/RP81/RE1); also elsewhere on the board
FGH: IC1.17 (PGEC1/AN6/RP38/RB6), ICSP1.P$3 (3)
GFD: IC1.18 (PGED1/AN7/RCV/RP39/RB7), ICSP1.P$2 (2)
GND: C1.1, C5.1, C6.2, C7.2, IC1.9 (VSS_2), IC1.25 (VSS_3), IC1.41 (VSS), ICSP1.P$1 (1), JP2.P$1 (1), Q1.2, Q1.4, R15.2, R16.2, R17.2, R18.2, R19.2, R20.2, R21.2, SW1.2 (S), SW2.1, SW3.1, U$27.P$1 (1), X1.5, X1.M1, X1.M2, X1.M3, X1.M4; also elsewhere on the board
G_AIN1: IC1.12 (AN4/C1INB/USBOEN/RP36/RB4); also elsewhere on the board
G_AIN2: IC1.13 (AN3/C2INA/VPIO/RP35/RB3); also elsewhere on the board
G_BIN1: IC1.14 (AN2/C2INB/VMIO/RP34/RB2); also elsewhere on the board
G_BIN2: IC1.15 (PGEC3/AN1/VREF-/RP33/RB1); also elsewhere on the board
H1_AIN1: IC1.49 (VCPCON/RP65/RD1); also elsewhere on the board
H1_AIN2: IC1.50 (DPH/RP66/RD2); also elsewhere on the board
H1_BIN1: IC1.51 (PMBE/RP67/RD3); also elsewhere on the board
H1_BIN2: IC1.52 (PMWR/RP68/RD4); also elsewhere on the board
H_AIN1: IC1.21 (AN8/PMA6/RP40/RB8); also elsewhere on the board
H_AIN2: IC1.22 (AN9/PMA7/RP41/RB9); also elsewhere on the board
H_BIN1: IC1.23 (TMS/AN10/CVREF/PMA13/RP42/RB10); also elsewhere on the board
H_BIN2: IC1.24 (TDO/AN11/PMA12/RP43/RB11); also elsewhere on the board
unnamed: C20.1, IC1.20 (AVSS)
unnamed: IC1.7 (!MCLR), R7.2
unnamed: C5.2, IC1.56 (VCAP)
unnamed: IC1.48 (PGEC2/SOSCO/C3INC/T1CK/RP62/RC14), LED3.A
unnamed: IC1.47 (PGED2/SOSCI/C3IND/RP61/RC13), LED4.A
unnamed: IC1.46 (INT0/DMH/RP64/RD0), LED5.A
unnamed: IC1.45 (PMCS1/RP75/RD11), LED6.A
unnamed: IC1.44 (ASCL1/PMCS2/RP74/RD10), LED7.A
unnamed: IC1.43 (ASDA1/DPLN/RP73/RD9), LED8.A
unnamed: IC1.42 (RTCC/DMLN/RP72/RD8), LED9.A
unnamed: LED9.C, R21.1
unnamed: LED8.C, R20.1
unnamed: LED7.C, R19.1
unnamed: LED6.C, R18.1
unnamed: LED5.C, R17.1
unnamed: LED4.C, R16.1
unnamed: LED3.C, R15.1
unnamed: IC1.30 (AN15/PMA0/RP47/RB15), SW1.1
RST: C1.2, R6.2, R7.1, U$28.P$1 (1)
SW2: IC1.53 (PMRD/RP69/RD5), SW2.2 (S)
SW3: IC1.54 (C3INB/RP70/RD6), SW3.2 (S)
VBAT: IC1.11 (AN5/C1INA/VBUSON/VBUSST/RP37/RB5), U$27.P$2 (2); also elsewhere on the board
VBUS: IC1.34 (VBUS)

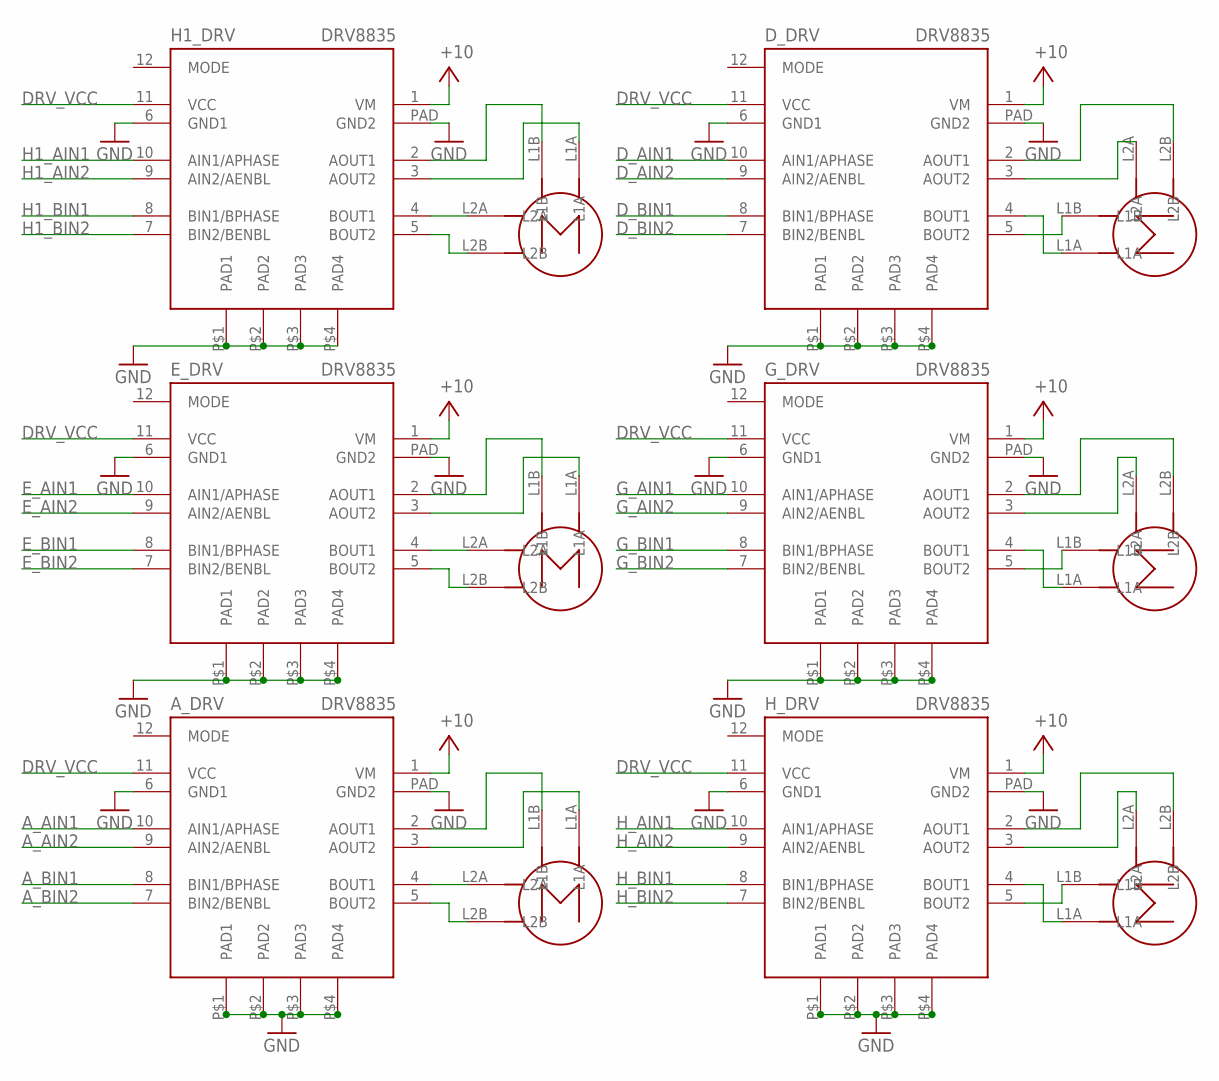
[picture p57: schematic board.sch, sheet 2]

Parts:
A_DRV: DRV8835; WSON_2X3
D_DRV: DRV8835; WSON_2X3
E_DRV: DRV8835; WSON_2X3
G_DRV: DRV8835; WSON_2X3
H1_DRV: DRV8835; WSON_2X3
H1šWF: H1; STEP_MOTOR
H_DRV: DRV8835; WSON_2X3
U$2, U$3, U$7: STEP_MOTOR_MIRROR
U$4, U$6: STEP_MOTOR

Connections:
+10V: A_DRV.1 (VM), D_DRV.1 (VM), E_DRV.1 (VM), G_DRV.1 (VM), H1_DRV.1 (VM), H_DRV.1 (VM); also elsewhere on the board
A_AIN1: A_DRV.10 (AIN1/APHASE); also elsewhere on the board
A_AIN2: A_DRV.9 (AIN2/AENBL); also elsewhere on the board
A_BIN1: A_DRV.8 (BIN1/BPHASE); also elsewhere on the board
A_BIN2: A_DRV.7 (BIN2/BENBL); also elsewhere on the board
DRV_VCC: A_DRV.11 (VCC), D_DRV.11 (VCC), E_DRV.11 (VCC), G_DRV.11 (VCC), H1_DRV.11 (VCC), H_DRV.11 (VCC); also elsewhere on the board
D_AIN1: D_DRV.10 (AIN1/APHASE); also elsewhere on the board
D_AIN2: D_DRV.9 (AIN2/AENBL); also elsewhere on the board
D_BIN1: D_DRV.8 (BIN1/BPHASE); also elsewhere on the board
D_BIN2: D_DRV.7 (BIN2/BENBL); also elsewhere on the board
E_AIN1: E_DRV.10 (AIN1/APHASE); also elsewhere on the board
E_AIN2: E_DRV.9 (AIN2/AENBL); also elsewhere on the board
E_BIN1: E_DRV.8 (BIN1/BPHASE); also elsewhere on the board
E_BIN2: E_DRV.7 (BIN2/BENBL); also elsewhere on the board
GND: A_DRV.6 (GND1), A_DRV.P$1 (PAD1), A_DRV.P$2 (PAD2), A_DRV.P$3 (PAD3), A_DRV.P$4 (PAD4), A_DRV.PAD (GND2), D_DRV.6 (GND1), D_DRV.P$1 (PAD1), D_DRV.P$2 (PAD2), D_DRV.P$3 (PAD3), D_DRV.P$4 (PAD4), D_DRV.PAD (GND2), E_DRV.6 (GND1), E_DRV.P$1 (PAD1), E_DRV.P$2 (PAD2), E_DRV.P$3 (PAD3), E_DRV.P$4 (PAD4), E_DRV.PAD (GND2), G_DRV.6 (GND1), G_DRV.P$1 (PAD1), G_DRV.P$2 (PAD2), G_DRV.P$3 (PAD3), G_DRV.P$4 (PAD4), G_DRV.PAD (GND2), H1_DRV.6 (GND1), H1_DRV.P$1 (PAD1), H1_DRV.P$2 (PAD2), H1_DRV.P$3 (PAD3), H1_DRV.P$4 (PAD4), H1_DRV.PAD (GND2), H_DRV.6 (GND1), H_DRV.P$1 (PAD1), H_DRV.P$2 (PAD2), H_DRV.P$3 (PAD3), H_DRV.P$4 (PAD4), H_DRV.PAD (GND2); also elsewhere on the board
G_AIN1: G_DRV.10 (AIN1/APHASE); also elsewhere on the board
G_AIN2: G_DRV.9 (AIN2/AENBL); also elsewhere on the board
G_BIN1: G_DRV.8 (BIN1/BPHASE); also elsewhere on the board
G_BIN2: G_DRV.7 (BIN2/BENBL); also elsewhere on the board
H1_AIN1: H1_DRV.10 (AIN1/APHASE); also elsewhere on the board
H1_AIN2: H1_DRV.9 (AIN2/AENBL); also elsewhere on the board
H1_BIN1: H1_DRV.8 (BIN1/BPHASE); also elsewhere on the board
H1_BIN2: H1_DRV.7 (BIN2/BENBL); also elsewhere on the board
H_AIN1: H_DRV.10 (AIN1/APHASE); also elsewhere on the board
H_AIN2: H_DRV.9 (AIN2/AENBL); also elsewhere on the board
H_BIN1: H_DRV.8 (BIN1/BPHASE); also elsewhere on the board
H_BIN2: H_DRV.7 (BIN2/BENBL); also elsewhere on the board
unnamed: D_DRV.2 (AOUT1), U$2.L2B
unnamed: D_DRV.3 (AOUT2), U$2.L2A
unnamed: D_DRV.5 (BOUT2), U$2.L1B
unnamed: D_DRV.4 (BOUT1), U$2.L1A
unnamed: G_DRV.2 (AOUT1), U$3.L2B
unnamed: G_DRV.3 (AOUT2), U$3.L2A
unnamed: G_DRV.5 (BOUT2), U$3.L1B
unnamed: G_DRV.4 (BOUT1), U$3.L1A
unnamed: E_DRV.5 (BOUT2), U$4.L2B
unnamed: H_DRV.4 (BOUT1), U$7.L1A
unnamed: E_DRV.2 (AOUT1), U$4.L1B
unnamed: E_DRV.3 (AOUT2), U$4.L1A
unnamed: E_DRV.4 (BOUT1), U$4.L2A
unnamed: A_DRV.5 (BOUT2), U$6.L2B
unnamed: H1_DRV.2 (AOUT1), H1šWF.L1B
unnamed: H1_DRV.3 (AOUT2), H1šWF.L1A
unnamed: H1_DRV.5 (BOUT2), H1šWF.L2B
unnamed: H1_DRV.4 (BOUT1), H1šWF.L2A
unnamed: A_DRV.2 (AOUT1), U$6.L1B
unnamed: A_DRV.3 (AOUT2), U$6.L1A
unnamed: A_DRV.4 (BOUT1), U$6.L2A
unnamed: H_DRV.2 (AOUT1), U$7.L2B
unnamed: H_DRV.3 (AOUT2), U$7.L2A
unnamed: H_DRV.5 (BOUT2), U$7.L1B

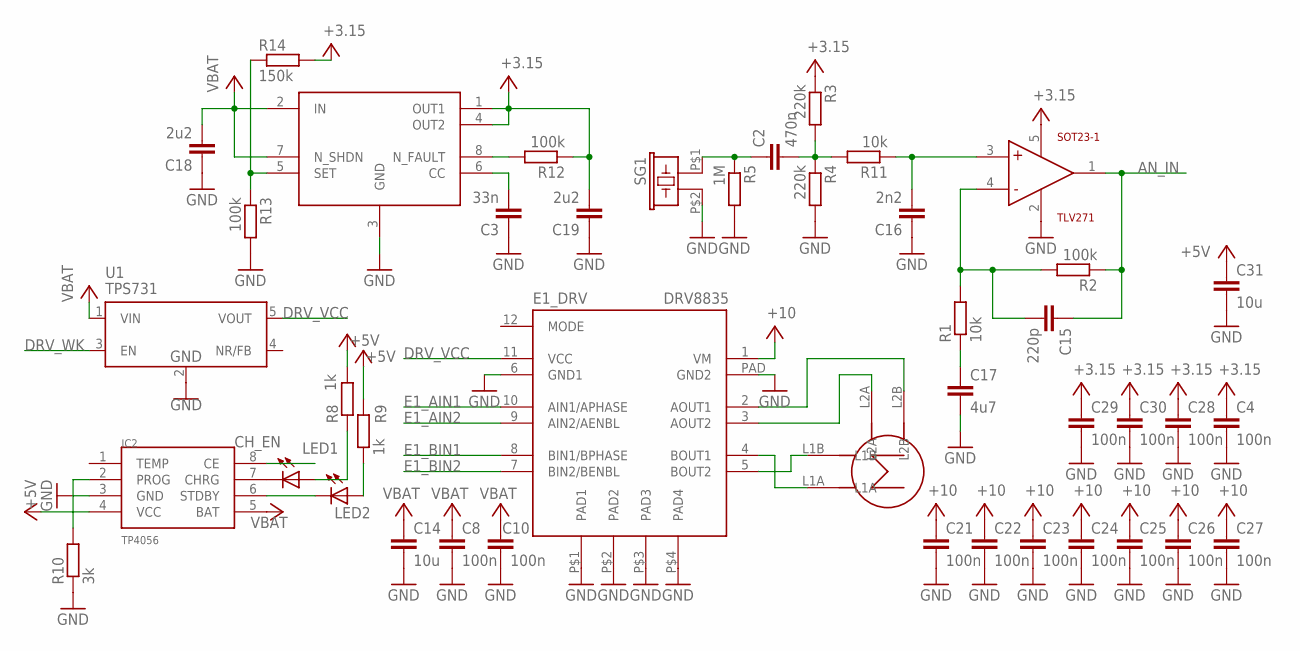
[picture p58: schematic board.sch, sheet 3]

Parts:
C2: 470n; C0805
C3: 33n; C0805
C4, C8, C10, C21, C22, C23, C24, C25, C26, C27, C28, C29, C30: 100n; C1206
C14, C31: 10u; C1206
C15: 220p; C0805
C16: 2n2; C0805
C17: 4u7; C1206
C18, C19: 2u2; C0805
E1_DRV: DRV8835; WSON_2X3
IC2: TP4056; SOP-8
LED1, LED2: LED_ESML0603; LED_SML0603
R1, R11: 10k; R0805
R2, R12, R13: 100k; R0805
R3, R4: 220k; R0805
R5: 1M; R0805
R8, R9: 1k; R0805
R10: 3k; R0805
R14: 150k; R0805
SG1: EFBAA40D101
SOT23-1: TLV271; SOT23-5
U1: TPS731; SOT25
U$1: STEP_MOTOR_MIRROR
U$8: LP3982

Connections:
+5V: C31.1, IC2.4 (VCC), R8.2, R9.2; also elsewhere on the board
+10V: C21.1, C22.1, C23.1, C24.1, C25.1, C26.1, C27.1, E1_DRV.1 (VM); also elsewhere on the board
AN_IN: C15.1, R2.1, SOT23-1.1 (OUT); also elsewhere on the board
CH_EN: IC2.8 (CE); also elsewhere on the board
DRV_VCC: E1_DRV.11 (VCC), U1.5 (VOUT); also elsewhere on the board
DRV_WK: U1.3 (EN); also elsewhere on the board
E1_AIN1: E1_DRV.10 (AIN1/APHASE); also elsewhere on the board
E1_AIN2: E1_DRV.9 (AIN2/AENBL); also elsewhere on the board
E1_BIN1: E1_DRV.8 (BIN1/BPHASE); also elsewhere on the board
E1_BIN2: E1_DRV.7 (BIN2/BENBL); also elsewhere on the board
GND: C3.1, C4.2, C8.2, C10.2, C14.2, C16.1, C17.2, C18.1, C19.1, C21.2, C22.2, C23.2, C24.2, C25.2, C26.2, C27.2, C28.2, C29.2, C30.2, C31.2, E1_DRV.6 (GND1), E1_DRV.P$1 (PAD1), E1_DRV.P$2 (PAD2), E1_DRV.P$3 (PAD3), E1_DRV.P$4 (PAD4), E1_DRV.PAD (GND2), IC2.3 (GND), R4.2, R5.2, R10.1, R13.2, SG1.P$2 (2), SOT23-1.2 (GND), U1.2 (GND), U$8.3 (GND); also elsewhere on the board
unnamed: C15.2, R1.2, R2.2, SOT23-1.4 (IN-)
unnamed: C17.1, R1.1
unnamed: C2.2, R3.2, R4.1, R11.2
unnamed: IC2.7 (CHRG), LED1.C
unnamed: C2.1, R5.1, SG1.P$1 (1)
unnamed: E1_DRV.2 (AOUT1), U$1.L2B
unnamed: E1_DRV.3 (AOUT2), U$1.L2A
unnamed: E1_DRV.4 (BOUT1), U$1.L1A
unnamed: E1_DRV.5 (BOUT2), U$1.L1B
unnamed: IC2.6 (STDBY), LED2.C
unnamed: LED2.A, R9.1
unnamed: LED1.A, R8.1
unnamed: IC2.2 (PROG), R10.2
unnamed: C16.2, R11.1, SOT23-1.3 (IN+)
unnamed: R12.2, U$8.8 (N_FAULT)
unnamed: C3.2, U$8.6 (CC)
unnamed: R13.1, R14.1, U$8.5 (SET)
VBAT: C8.1, C10.1, C14.1, C18.2, IC2.5 (BAT), U1.1 (VIN), U$8.2 (IN), U$8.7 (N_SHDN); also elsewhere on the board

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
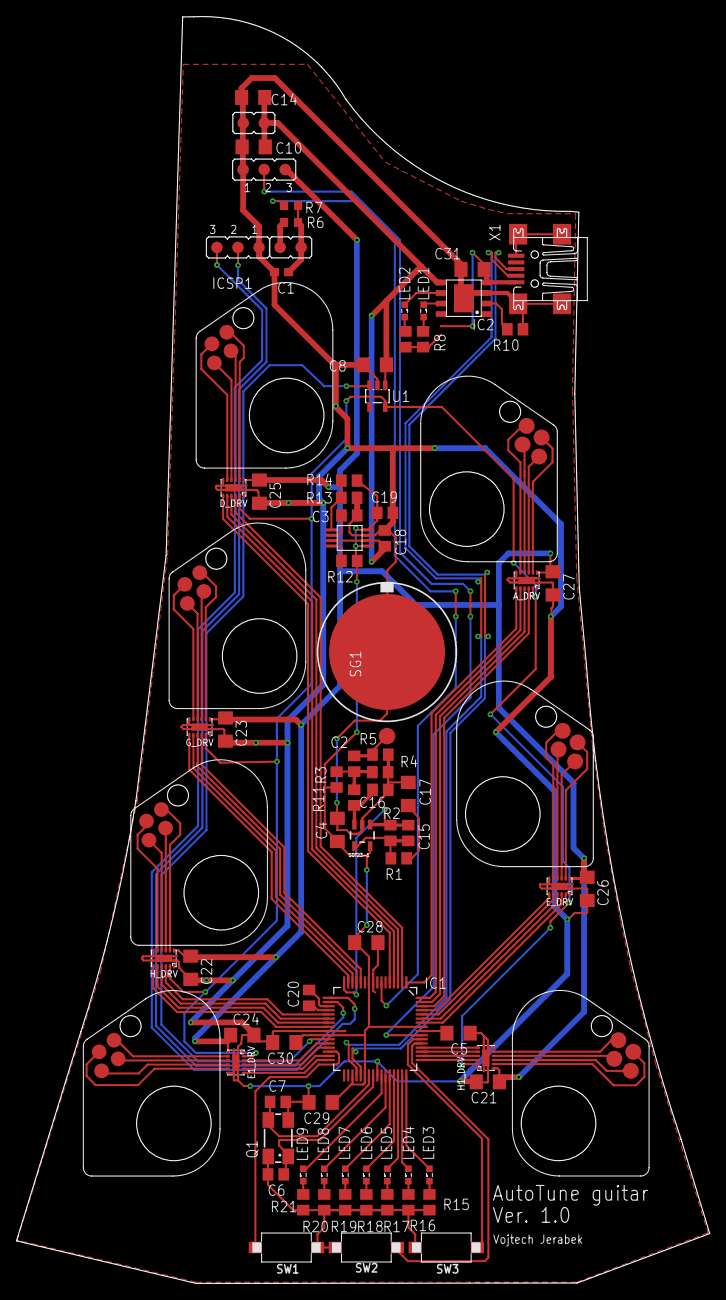
[picture p59: board board.brd from above]

Board: 2 copper layers, 83.7 x 153.0 mm, 86 parts (0 on the bottom side), 108 nets.
