recrutty/AutotuneGuitar/deska - kopie/krokovy motor pokus.brd

## EAGLE design deska - kopie/krokovy motor pokus.brd (2017-02-22, an earlier design)

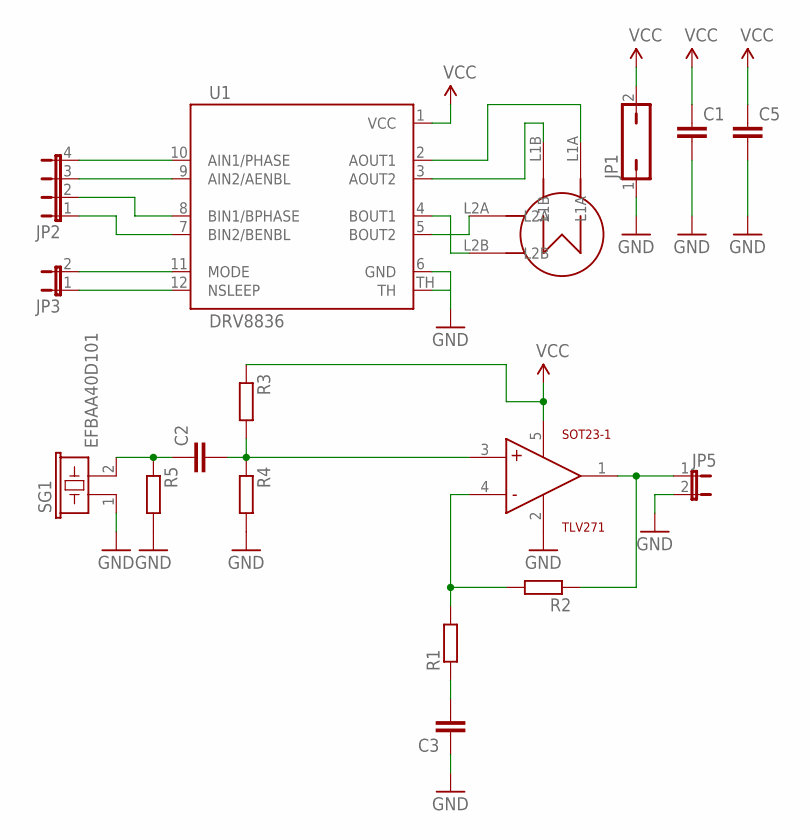
[picture p60: schematic krokovy motor pokus.sch]

Parts:
C1, C2, C3, C5: CC1206; C1206
JP1: JP1Q; JP1
JP2: JP4E; JP4
JP3, JP5: JP1E; JP1
R1, R2, R3, R4, R5: RR1206; R1206
SG1: EFBAA40D101
SOT23-1: TLV271; SOT23-5
U1: DRV8836; 12WSON
U$1: STEP_MOTOR

Connections:
GND: C1.2, C3.1, C5.2, JP1.1, JP5.2, R4.2, R5.2, SG1.1, SOT23-1.2 (GND), U1.6 (GND), U1.TH
unnamed: JP2.4, U1.10 (AIN1/PHASE)
unnamed: JP2.3, U1.9 (AIN2/AENBL)
unnamed: JP2.2, U1.8 (BIN1/BPHASE)
unnamed: JP2.1, U1.7 (BIN2/BENBL)
unnamed: JP3.1, U1.12 (NSLEEP)
unnamed: JP3.2, U1.11 (MODE)
unnamed: U1.2 (AOUT1), U$1.L1A
unnamed: U1.3 (AOUT2), U$1.L1B
unnamed: U1.5 (BOUT2), U$1.L2A
unnamed: U1.4 (BOUT1), U$1.L2B
unnamed: JP5.1, R2.1, SOT23-1.1 (OUT)
unnamed: R1.2, R2.2, SOT23-1.4 (IN-)
unnamed: C3.2, R1.1
unnamed: C2.2, R3.2, R4.1, SOT23-1.3 (IN+)
unnamed: C2.1, R5.1, SG1.2
VCC: C1.1, C5.1, JP1.2, R3.1, SOT23-1.5 (VDD), U1.1 (VCC)

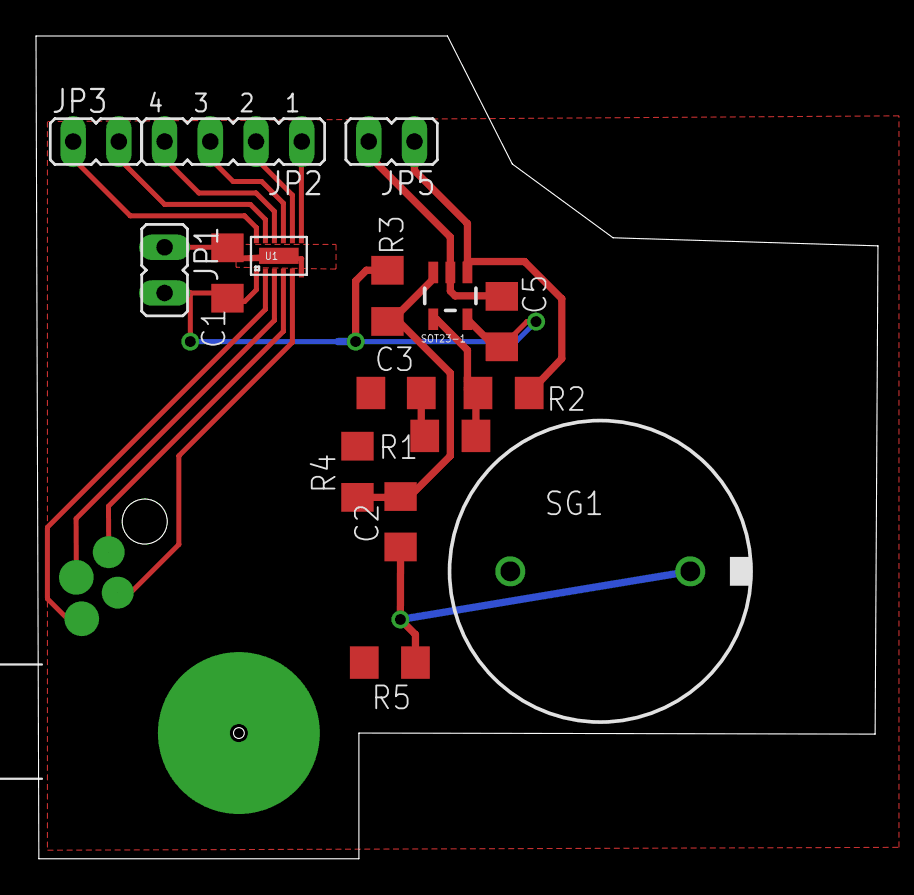
[picture p61: board krokovy motor pokus.brd from above]

Board: 2 copper layers, 46.8 x 45.7 mm, 17 parts (0 on the bottom side), 17 nets.
