recrutty/AutotuneGuitar/sepisovani/Na CD/Program MCU/stepper_motors.c

#include "GPIO_binding.h"
#include <stdint.h>
#include "xc.h"
#include "stepper_motors.h"

extern StepMotor *StepperMotorList[];

void MotorsSleep()
{
    *STEP_WK_PORT &= ~(1 << STEP_WK_BIT);
}
void MotorsWake()
{    
    *STEP_WK_PORT |= (1 << STEP_WK_BIT);
}
void MotorOff(StepMotorIndex motorNum)
{
    *(StepperMotorList[motorNum]->CoilA->Port) &= ~(0b11 << (StepperMotorList[motorNum]->CoilA->FirstPin));
    *(StepperMotorList[motorNum]->CoilB->Port) &= ~(0b11 << (StepperMotorList[motorNum]->CoilB->FirstPin));
}
void DoSteps(StepMotorIndex motorNum, StepMotorDirection dir, uint16_t stepsNum)
{
    StepperMotorList[motorNum]->LastState.RemainingSteps = stepsNum;
    StepperMotorList[motorNum]->LastState.Direction = dir;
}

void DoStep(StepMotorIndex motorNum, StepMotorDirection dir)
{
    StepMotorCoil *xcoilA = (StepMotorCoil*)(StepperMotorList[motorNum]->CoilA);
    StepMotorCoil *xcoilB = (StepMotorCoil*)(StepperMotorList[motorNum]->CoilB);
    
    int8_t *xstate = (int8_t*)&(StepperMotorList[motorNum]->LastState.RotationState);
    (*xstate)++;
    dir -= (StepperMotorList[motorNum]->DifferentDirection);

    if(dir)
    {
        switch(*xstate) 
        {
        case 0 :        
            *(xcoilA->Port) &= ~(0b11 << xcoilA->FirstPin);
            break;

        case 1 :
            *(xcoilA->Port) |= (0b01 << xcoilA->FirstPin);
            break;

        case 2 :
            *(xcoilB->Port) &= ~(0b11 << xcoilB->FirstPin);
            break;

        case 3 :
            *(xcoilB->Port) |= (0b01 << xcoilB->FirstPin);
            break;	

        case 4 :
            *(xcoilA->Port) &= ~(0b11 << xcoilA->FirstPin);
            break;	

        case 5 :
            *(xcoilA->Port) |= (0b10 << xcoilA->FirstPin);
            break;	

        case 6 :
            *(xcoilB->Port) &= ~(0b11 << xcoilB->FirstPin);
            break;	

        case 7 :
            *(xcoilB->Port) |= (0b10 << xcoilB->FirstPin);
            break;

        case 8 :
            *(xcoilA->Port) &= ~(0b11 << xcoilA->FirstPin);
            *xstate = 0;
            break;

        default :
            *xstate = 0;
            break;
        }
    }
    else
    {        
        switch(*xstate) 
        {
        case 0 :        
            *(xcoilA->Port) &= ~(0b11 << xcoilA->FirstPin);
            break;

        case 1 :
            *(xcoilA->Port) |= (0b10 << xcoilA->FirstPin);
            break;

        case 2 :
            *(xcoilB->Port) &= ~(0b11 << xcoilB->FirstPin);
            break;

        case 3 :
            *(xcoilB->Port) |= (0b01 << xcoilB->FirstPin);
            break;	

        case 4 :
            *(xcoilA->Port) &= ~(0b11 << xcoilA->FirstPin);
            break;	

        case 5 :
            *(xcoilA->Port) |= (0b01 << xcoilA->FirstPin);
            break;	

        case 6 :
            *(xcoilB->Port) &= ~(0b11 << xcoilB->FirstPin);
            break;	

        case 7 :
            *(xcoilB->Port) |= (0b10 << xcoilB->FirstPin);
            break;

        case 8 :
            *(xcoilA->Port) &= ~(0b11 << xcoilA->FirstPin);
            *xstate = 0;
            break;

        default :
            *xstate = 0;
            break;
        }
    }

    StepperMotorList[motorNum]->LastState.RemainingSteps--;
}
void InitMotors()
{
    StepMotorIndex i;
    for (i = 0; i < eStepperMotorNum; i++) 
    {
        StepMotorCoil *xcoil = (StepMotorCoil*)(StepperMotorList[i]->CoilA);
        *(xcoil->Tris) &= ~(0b11 << xcoil->FirstPin);
        *(xcoil->Ansel) &= ~(0b11 << xcoil->FirstPin);
        *(xcoil->Port) &= ~(0b11 << xcoil->FirstPin);
        
        xcoil = (StepMotorCoil*)(StepperMotorList[i]->CoilB);
        *(xcoil->Tris) &= ~(0b11 << xcoil->FirstPin);
        *(xcoil->Ansel) &= ~(0b11 << xcoil->FirstPin);
        *(xcoil->Port) &= ~(0b11 << xcoil->FirstPin);
    }
    
    *STEP_WK_DIR &= ~(1 << STEP_WK_BIT);
    *STEP_WK_ANSEL &= ~(1 << STEP_WK_BIT);
    
    *STEP_POW_DIR &= ~(1 << STEP_POW_BIT);
    *STEP_POW_ANSEL &= ~(1 << STEP_POW_BIT);
    
}
