recrutty/AutotuneGuitar/sepisovani/Na CD/Program MCU/Leds.c

#include "GPIO_binding.h"
#include <stdint.h>
#include "xc.h"
#include "Leds.h"

extern Led *LedList[];

void InitLeds()
{
    LedIndex i;
    for (i = 0; i < eLedNum; i++) 
    {
        Led *xLed = LedList[i];
        *(xLed->Tris) &= ~(1 << (xLed->LedPin));
        *(xLed->Ansel) &= ~(1 << (xLed->LedPin));
    }    
}

void TurnLedOn(LedIndex ledNum)
{
    *(LedList[ledNum]->Port) |= (1 << LedList[ledNum]->LedPin);                
}

void TurnLedOff(LedIndex ledNum)
{
    *(LedList[ledNum]->Port) &= ~(1 << LedList[ledNum]->LedPin);                
}

void OneLedOn(LedIndex ledNum)
{    
    AllLedsOff();
    TurnLedOn(ledNum);
}
void OneLedOff(LedIndex ledNum)
{    
    AllLedsOn();
    TurnLedOff(ledNum);
}
void InverseLeds()
{    
    LedIndex i;
    for (i = 0; i < eLedNum; i++) 
    {
        Led *xLed = LedList[i];
        *(xLed->Port) ^= (1 << (xLed->LedPin));
    }   
}
void AllLedsOff()
{    
    LedIndex i;
    for (i = 0; i < eLedNum; i++) 
    {
        Led *xLed = LedList[i];
        *(xLed->Port) &= ~(1 << (xLed->LedPin));
    }   
}

void AllLedsOn()
{    
    LedIndex i;
    for (i = 0; i < eLedNum; i++) 
    {
        Led *xLed = LedList[i];
        *(xLed->Port) |= (1 << (xLed->LedPin));
    }   
}
