recrutty/AutotuneGuitar/sepisovani/Na CD/Program MCU/Strings_freq.h

#ifndef STRINGS_FREQ_H
#define	STRINGS_FREQ_H


#define FREQ_a1 (440)
#define SEMITONE_1_MULTIPLIER ((double)(1.059463094359))
#define SEMITONE_2_MULTIPLIER ((double)(1.122462048309))
#define SEMITONE_3_MULTIPLIER ((double)(1.189207115003))
#define SEMITONE_4_MULTIPLIER ((double)(1.259921049895))
#define SEMITONE_5_MULTIPLIER ((double)(1.334839854170))
#define SEMITONE_6_MULTIPLIER ((double)(1.414213562373))
#define SEMITONE_7_MULTIPLIER ((double)(1.498307076877))
#define SEMITONE_8_MULTIPLIER ((double)(1.587401051968))
#define SEMITONE_9_MULTIPLIER ((double)(1.681792830507))
#define SEMITONE_10_MULTIPLIER ((double)(1.781797436281))
#define SEMITONE_11_MULTIPLIER ((double)(1.887748625363))

#endif	/* STRINGS_FREQ_H */
