recrutty/AutotuneGuitar/SW/Auto_Tune_guitar_1/Led_list.h

LED(Led1, LED1_PORT, LED1_DIR, LED1_ANSEL, LED1_BIT)
LED(Led2, LED2_PORT, LED2_DIR, LED2_ANSEL, LED2_BIT)
LED(Led3, LED3_PORT, LED3_DIR, LED3_ANSEL, LED3_BIT)
LED(Led4, LED4_PORT, LED4_DIR, LED4_ANSEL, LED4_BIT)
LED(Led5, LED5_PORT, LED5_DIR, LED5_ANSEL, LED5_BIT)
LED(Led6, LED6_PORT, LED6_DIR, LED6_ANSEL, LED6_BIT)
LED(Led7, LED7_PORT, LED7_DIR, LED7_ANSEL, LED7_BIT)
