recrutty/AutotuneGuitar/sepisovani/Na CD/Program MCU/system.h

#ifndef SYSTEM_H
#define	SYSTEM_H

    #define SYS_FREQ        7370000L
    #define FCY             SYS_FREQ/2

    void ConfigureOscillator(void); /* Handles clock switching/osc initialization */

#endif	/* SYSTEM_H */
