recrutty/AutotuneGuitar/ce482_fft_dsplib/firmware/src/system_config/exp16/dspic33ep256gp506/main_fft_example.c

/*******************************************************************************
  Company:
    Microchip Technology Inc.

  File Name:
    main_fft_example.c

  Summary:
    This file is used to call the FFT related functions.

  Description:
    This file includes the function calls for FFTComplexIP, BitReverseComplex,
    SquareMagnitudeCplx functions that are central to the computation of the FFT
    of an input signal and then the peak frequency is calculated.
*******************************************************************************/
/*******************************************************************************
Copyright (c) 2012 released Microchip Technology Inc.  All rights reserved.

Microchip licenses to you the right to use, modify, copy and distribute
Software only when embedded on a Microchip microcontroller or digital signal
controller that is integrated into your product or third party product
(pursuant to the sublicense terms in the accompanying license agreement).

You should refer to the license agreement accompanying this Software for
additional information regarding your rights and obligations.

SOFTWARE AND DOCUMENTATION ARE PROVIDED "AS IS" WITHOUT WARRANTY OF ANY KIND,
EITHER EXPRESS OR IMPLIED, INCLUDING WITHOUT LIMITATION, ANY WARRANTY OF
MERCHANTABILITY, TITLE, NON-INFRINGEMENT AND FITNESS FOR A PARTICULAR PURPOSE.
IN NO EVENT SHALL MICROCHIP OR ITS LICENSORS BE LIABLE OR OBLIGATED UNDER
CONTRACT, NEGLIGENCE, STRICT LIABILITY, CONTRIBUTION, BREACH OF WARRANTY, OR
OTHER LEGAL EQUITABLE THEORY ANY DIRECT OR INDIRECT DAMAGES OR EXPENSES
INCLUDING BUT NOT LIMITED TO ANY INCIDENTAL, SPECIAL, INDIRECT, PUNITIVE OR
CONSEQUENTIAL DAMAGES, LOST PROFITS OR LOST DATA, COST OF PROCUREMENT OF
SUBSTITUTE GOODS, TECHNOLOGY, SERVICES, OR ANY CLAIMS BY THIRD PARTIES
(INCLUDING BUT NOT LIMITED TO ANY DEFENSE THEREOF), OR OTHER SIMILAR COSTS.
*******************************************************************************/
// *****************************************************************************
// *****************************************************************************
// Section: Included Files
// *****************************************************************************
// *****************************************************************************

#include <xc.h>
#include <stdint.h>
#include <dsp.h>
#include "fft.h"

#if __XC16_VERSION < 1011
    #warning "Please upgrade to XC16 v1.11 or newer."
#endif

// *****************************************************************************
// *****************************************************************************
// Section: Macros for Configuration Fuse Registers:
// *****************************************************************************
// *****************************************************************************
// Invoke macros to set up  device configuration fuse registers.The fuses will
//   select the oscillator source, power-up timers, watch-dog timers etc. The
//   macros are defined within the device header files. The configuration fuse
//   registers reside in Flash memory.
 


// DSPIC33EP256MU806 Configuration Bit Settings

// 'C' source line config statements

// FGS
#pragma config GWRP = OFF               // General Segment Write-Protect bit (General Segment may be written)
#pragma config GSS = OFF                // General Segment Code-Protect bit (General Segment Code protect is disabled)
#pragma config GSSK = OFF               // General Segment Key bits (General Segment Write Protection and Code Protection is Disabled)

// FOSCSEL
#pragma config FNOSC = FRC              // Initial Oscillator Source Selection bits (Internal Fast RC (FRC))
#pragma config IESO = ON                // Two-speed Oscillator Start-up Enable bit (Start up device with FRC, then switch to user-selected oscillator source)

// FOSC
#pragma config POSCMD = NONE            // Primary Oscillator Mode Select bits (Primary Oscillator disabled)
#pragma config OSCIOFNC = ON            // OSC2 Pin Function bit (OSC2 is general purpose digital I/O pin)
#pragma config IOL1WAY = ON             // Peripheral pin select configuration (Allow only one reconfiguration)
#pragma config FCKSM = CSDCMD           // Clock Switching Mode bits (Both Clock switching and Fail-safe Clock Monitor are disabled)

// FWDT
#pragma config WDTPOST = PS8192         // Watchdog Timer Postscaler bits (1:8,192)
#pragma config WDTPRE = PR128           // Watchdog Timer Prescaler bit (1:128)
#pragma config PLLKEN = OFF             // PLL Lock Wait Enable bit (Clock switch will not wait for the PLL lock signal.)
#pragma config WINDIS = OFF             // Watchdog Timer Window Enable bit (Watchdog Timer in Non-Window mode)
#pragma config FWDTEN = OFF             // Watchdog Timer Enable bit (Watchdog timer enabled/disabled by user software)

// FPOR
#pragma config FPWRT = PWR128           // Power-on Reset Timer Value Select bits (128ms)
#pragma config BOREN = OFF              // Brown-out Reset (BOR) Detection Enable bit (BOR is disabled)
#pragma config ALTI2C1 = OFF            // Alternate I2C pins for I2C1 (SDA1/SCK1 pins are selected as the I/O pins for I2C1)

// FICD
#pragma config ICS = PGD3               // ICD Communication Channel Select bits (Communicate on PGEC3 and PGED3)
#pragma config RSTPRI = PF              // Reset Target Vector Select bit (Device will obtain reset instruction from Primary flash)
#pragma config JTAGEN = ON              // JTAG Enable bit (JTAG is enabled)

// FAS
#pragma config AWRP = OFF               // Auxiliary Segment Write-protect bit (Aux Flash may be written)
#pragma config APL = OFF                // Auxiliary Segment Code-protect bit (Aux Flash Code protect is disabled)
#pragma config APLK = OFF               // Auxiliary Segment Key bits (Aux Flash Write Protection and Code Protection is Disabled)

// #pragma config statements should precede project file includes.
// Use project enums instead of #define for ON and OFF.



// *****************************************************************************
// *****************************************************************************
// Section: /* Extern definitions */
// *****************************************************************************
// *****************************************************************************
 // Typically, the input to an FFT  is a complex array containing samples
 // of an input signal. For this example, we will provide the input signal in an
 // array declared in Y-data space.
 extern fractcomplex sigCmpx[FFT_BLOCK_LENGTH]
__attribute__ ((eds, space(ymemory), aligned (FFT_BLOCK_LENGTH * 2 *2)));	      		/*  */

 /* Declare Twiddle Factor array in X-space*/
 #ifndef FFTTWIDCOEFFS_IN_PROGMEM
 fractcomplex twiddleFactors[FFT_BLOCK_LENGTH/2] 	
 __attribute__ ((section (".xbss, bss, xmemory"), aligned (FFT_BLOCK_LENGTH*2)));
 #else
 extern const fractcomplex twiddleFactors[FFT_BLOCK_LENGTH/2]	/* Twiddle Factor array in Program memory */
 __attribute__ ((space(prog), aligned (FFT_BLOCK_LENGTH*2)));
 #endif
 extern fractional input[FFT_BLOCK_LENGTH];
// *****************************************************************************
// *****************************************************************************
// Section: File Scope or Global Constants
// *****************************************************************************
// *****************************************************************************
fractional output[FFT_BLOCK_LENGTH/2];
int16_t	peakFrequencyBin = 0; // Declare post-FFT variables to compute the
uint32_t peakFrequency = 0; // frequency of the largest spectral component


/******************************************************************************
 * Function:        int main(void)
 *
 * PreCondition:    None
 *
 * Input:           None
 *
 * Output:          None
 *
 * Side Effects:    None
 *
 * Overview:        Sets CPU clock and initializes Ports and timer.
 *****************************************************************************/
#ifdef TEST_MODE
unsigned char test_flag;
#endif
#ifdef TEST_MODE
int ce_main(void)
#else
int main(void)
#endif
{

#ifdef TEST_MODE
    test_flag=0;
#endif
    int i = 0;
#ifndef FFTTWIDCOEFFS_IN_PROGMEM					/* Generate TwiddleFactor Coefficients */
    TwidFactorInit (LOG2_BLOCK_LENGTH, &twiddleFactors[0], 0);	/* We need to do this only once at start-up */
#endif

    for ( i = 0; i < FFT_BLOCK_LENGTH; i++ )/* The FFT function requires input data */
    {					/* to be in the fractional fixed-point range [-0.5, +0.5]*/
            sigCmpx[i].real = input[i] >> 1 ;		/* So, we shift all data samples by 1 bit to the right. */
            sigCmpx[i].imag = 0;			/* Should you desire to optimize this process, perform */
    }

	/* Perform FFT operation */
#ifndef FFTTWIDCOEFFS_IN_PROGMEM
    FFTComplexIP (LOG2_BLOCK_LENGTH, &sigCmpx[0], &twiddleFactors[0], COEFFS_IN_DATA);
#else
    FFTComplexIP (LOG2_BLOCK_LENGTH, &sigCmpx[0], (fractcomplex *) __builtin_psvoffset(&twiddleFactors[0]), (int) __builtin_psvpage(&twiddleFactors[0]));
#endif

    /* Store output samples in bit-reversed order of their addresses */
    BitReverseComplex (LOG2_BLOCK_LENGTH, &sigCmpx[0]);

    /* Compute the square magnitude of the complex FFT output array so we have a Real output vetor */
    SquareMagnitudeCplx(FFT_BLOCK_LENGTH/2, &sigCmpx[0], output);

    /* Find the frequency Bin ( = index into the SigCmpx[] array) that has the largest energy*/
    /* i.e., the largest spectral component */
    VectorMax(FFT_BLOCK_LENGTH/2, output, &peakFrequencyBin);

    /* Compute the frequency (in Hz) of the largest spectral component */
    peakFrequency = peakFrequencyBin*(SAMPLING_RATE/FFT_BLOCK_LENGTH);
#ifdef TEST_MODE
  while(1)  
  {
    if ((peakFrequency >= 950) && (peakFrequency <= 1050))
    {
            test_flag=1;
           return 0;
    }
    else
    {
        test_flag=0;
        return 1;
    }
  }
#else

    while (1);	/* Place a breakpoint here and observe the watch window variables */
#endif
}
/*******************************************************************************
 End of File
*/
