recrutty/AutotuneGuitar/(commit log)

2017-02-20 adding motors
2017-02-22 adding docs
    [Schecter7HS.dxf, board.brd, board.sch, diry.xlsx, frekvence strun.xlsx, gme koupit.xlsx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]
2017-02-22 better step motor, add ADC
2017-02-27 adding pins change leds structure
2017-02-27 deleting leds
2017-02-28 drivers testing
2017-03-06 high clk, high ADC
    [ADC DATA A counter.csv, ADC DATA E counter.csv, ADC DATA E.csv, ADC DATA E2.csv, ADC DATA E2low counter.csv, ADC DATA E3.csv, ADC DATA E4.csv, ADC DATA Elow counter.csv]
2017-03-07 mereni strun zaklad
    [Sešit1.xlsx, pll parametry.xlsx]
2017-03-09 5 strun ladi dobre. hluboke maj problem
    [ADC DATA E buffer.csv, ADC DATA E debug.csv, ADC DATA E movAv.csv, ADC DATA E2 debug.csv, ADC DATA E3 debug.csv, ADC DATA E4 debug.csv, ADC DATA E5 debug.csv, ADC DATA E6 debug.csv]
2017-03-09 vetsi klouzavy prumer
    [ADC DATA H debug.csv, ADC DATA none.csv, Sešit1.xlsx]
2017-03-09 mereni h struny
    [ADC DATA H debug unfiltered.csv, ADC DATA H debug unfiltered2.csv, Sešit1.xlsx]
2017-03-20 hrani s FFT. jeste nejede
    [D fractional.csv, D hack.csv, E hack 2.csv, E hack 3.csv, E hack.csv, E.csv, FFT.csv, dataForFFT D 0.csv]
2017-03-26 fft mereni
    [D FFT slow bv4.csv, D FFT slow.csv, D hack slow.csv, D hack vysleked 0.csv, E hack 4.csv, E hack 5.csv, Sešit1.xlsx, data.csv]
2017-04-04 mereni fft
    [Sešit1.xlsx, data.csv]
2017-04-17 SW pro prezentovani
    [Sešit1.xlsm, Sešit1.xlsx, data.csv]
2017-04-23 doplneni priloh
    [board.brd, board.sch]
2017-05-07 psani HW
    [board.sch, stepUp.sch]
2017-05-14 psani dal
    [Sešit1.xlsm, grafy.xlsx]
2017-05-21 Added StepMotor.xml
    [StepMotor.xml]
